WCP52/gpha/README.md

This repository contains the final product data for the WCP52 Gain/Phase
Analyzer.
