WCP52/gpha/PCB/README.rst

This is the final PCB for WCP52's gain/phase analyzer BSEE capstone project.
Layout is done in KiCad (latest testing revision) with libraries from
@cpavlina:

- https://github.com/cpavlina/kicad-schlib
- https://github.com/cpavlina/kicad-pcblib
