WCP52/gpha/PCB/RENDERS/3d-full.png

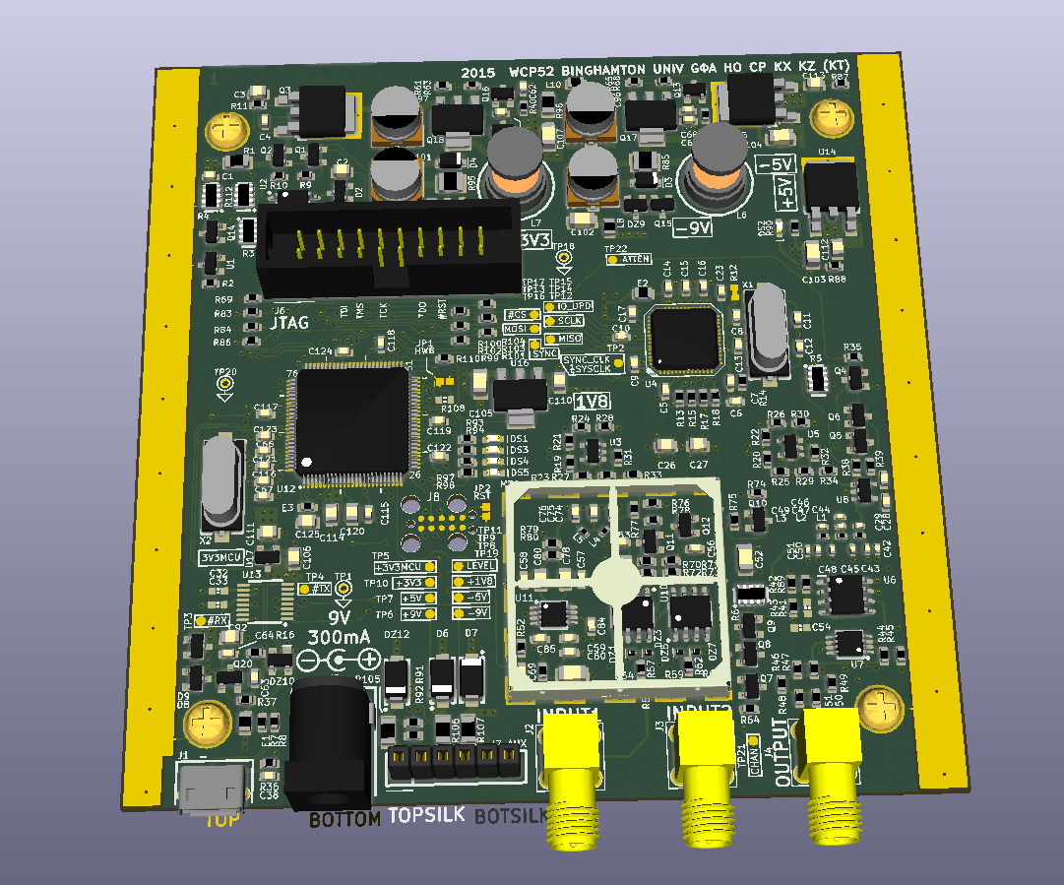
PCB/RENDERS/3d-full.png
