WCP52/gpha/PCB/RENDERS/schematic_small.png

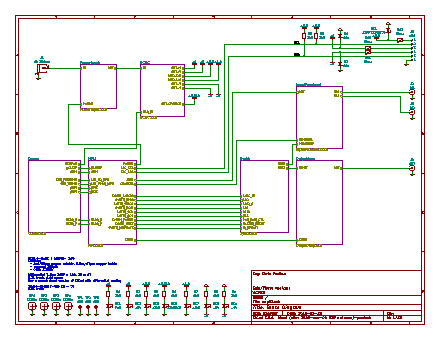
PCB/RENDERS/schematic_small.png
