WCP52/gpha/OwnersManual/autogen-bom.tex

\begin{longtable}{|l|l|l|l|l|}
\hline
\textbf{Reference} & \textbf{Manufacturer} & \textbf{Part Number} & \textbf{Line} & \textbf{Description} \\
\hline
\endhead
C1 &  &  & CAP MLCC 10n 50V 10\% \ensuremath{\geq}X5R [0603] &  \\
\hline
C2 &  &  & CAP MLCC 10n 50V 10\% \ensuremath{\geq}X5R [0603] &  \\
\hline
C3 &  &  & CAP MLCC 100n 16V 10\% \ensuremath{\geq}X7R [0603] &  \\
\hline
C4 &  &  & CAP MLCC 10n 50V 10\% \ensuremath{\geq}X5R [0603] &  \\
\hline
C5 &  &  & CAP MLCC 10\ensuremath{\mu} 10V 10\% \ensuremath{\geq}X5R [0805] &  \\
\hline
C8 &  &  & CAP MLCC 100n 16V 10\% \ensuremath{\geq}X7R [0603] &  \\
\hline
C9 &  &  & CAP MLCC 100n 16V 10\% \ensuremath{\geq}X7R [0603] &  \\
\hline
C10 &  &  & CAP MLCC 100n 16V 10\% \ensuremath{\geq}X7R [0603] &  \\
\hline
C11 &  &  & CAP MLCC 100n 16V 10\% \ensuremath{\geq}X7R [0603] &  \\
\hline
C12 &  &  & CAP MLCC 100n 16V 10\% \ensuremath{\geq}X7R [0603] &  \\
\hline
C13 &  &  & CAP MLCC 100n 16V 10\% \ensuremath{\geq}X7R [0603] &  \\
\hline
C14 &  &  & CAP MLCC 15p 50V 10\% C0G [0603] &  \\
\hline
C15 &  &  & CAP MLCC 15p 50V 10\% C0G [0603] &  \\
\hline
C16 &  &  & CAP MLCC 100n 16V 10\% \ensuremath{\geq}X7R [0603] &  \\
\hline
C17 &  &  & CAP MLCC 100n 16V 10\% \ensuremath{\geq}X7R [0603] &  \\
\hline
C18 &  &  & CAP MLCC 100n 16V 10\% \ensuremath{\geq}X7R [0603] &  \\
\hline
C19 &  &  & CAP MLCC 100n 16V 10\% \ensuremath{\geq}X7R [0603] &  \\
\hline
C20 &  &  & CAP MLCC 100n 16V 10\% \ensuremath{\geq}X7R [0603] &  \\
\hline
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
\hline
R98 &  &  & RES SMD 3R3 10\% [0603] &  \\
\hline
R99 &  &  & RES SMD 3R3 10\% [0603] &  \\
\hline
R102 &  &  & RES SMD 3k3 5\% [0603] &  \\
\hline
R103 &  &  & RES SMD 3k3 5\% [0603] &  \\
\hline
R104 &  &  & RES SMD 3k3 5\% [0603] &  \\
\hline
R105 &  &  & RES SMD 3k3 5\% [0603] &  \\
\hline
R106 &  &  & RES SMD 1k 5\% [0603] &  \\
\hline
R107 &  &  & RES SMD 1k 5\% [0603] &  \\
\hline
R108 &  &  & RES SMD 1k 5\% [0603] &  \\
\hline
R109 &  &  & RES SMD 1k 5\% [0603] &  \\
\hline
R110 &  &  & RES SMD 200 1\% [0603] &  \\
\hline
R111 &  &  & RES SMD 3k3 5\% [0603] &  \\
\hline
R112 &  &  & RES SMD 200 1\% [0603] &  \\
\hline
R113 &  &  & RES SMD 200 1\% [0603] &  \\
\hline
R114 &  &  & RES SMD 200 1\% [0603] &  \\
\hline
R115 &  &  & RES SMD 200 1\% [0603] &  \\
\hline
R116 &  &  & RES SMD 200 1\% [0603] &  \\
\hline
R117 &  &  & RES SMD 360 1\% [0603] &  \\
\hline
U2 &  &  & IC TI LMH6714MF &  \\
\hline
U3 &  &  & IC ADI AD9958BCPZ &  \\
\hline
U4 &  &  & IC TI LMH6714MF &  \\
\hline
U5 &  &  & IC ADI AD8000YRDZ &  \\
\hline
U6 &  &  & IC TI THS3001IDGN &  \\
\hline
U7 &  &  & IC MACOM MAADSS0008 &  \\
\hline
U8 &  &  & IC MACOM MASWSS0162 &  \\
\hline
U9 &  &  & IC MACOM MASWSS0162 &  \\
\hline
U10 &  &  & IC ADI AD8310ARMZ &  \\
\hline
U11 &  &  & IC TI TL431AIDBZ &  \\
\hline
U12 &  &  & IC GENERIC LM393M &  \\
\hline
U13 &  &  & IC ST L78M05CDT &  \\
\hline
U14 &  &  & IC ONSEMI MC79M05CDTG &  \\
\hline
U15 &  &  & IC DIODES AZ1117CH-1.8TRG1 &  \\
\hline
U16 &  &  & IC MICROCHIP MCP1700T-3302E/TT &  \\
\hline
U18 &  &  & IC ATMEL ATSAM4S4CA-AU &  \\
\hline
X1 & TXC & 9C-25.000MEEJ-T & DIST DIGIKEY 887-1283-1-ND & CRYSTAL 25MHz 18pF 10PPM \\
\hline
X2 & Abracon & ABLS-12.000MHZ-B4-T & DIST DIGIKEY 535-10218-1-ND & CRYSTAL 12MHz 18pF \\
\hline
\end{longtable}
