WCP52/gpha/PCB/RENDERS/schematic.pdf

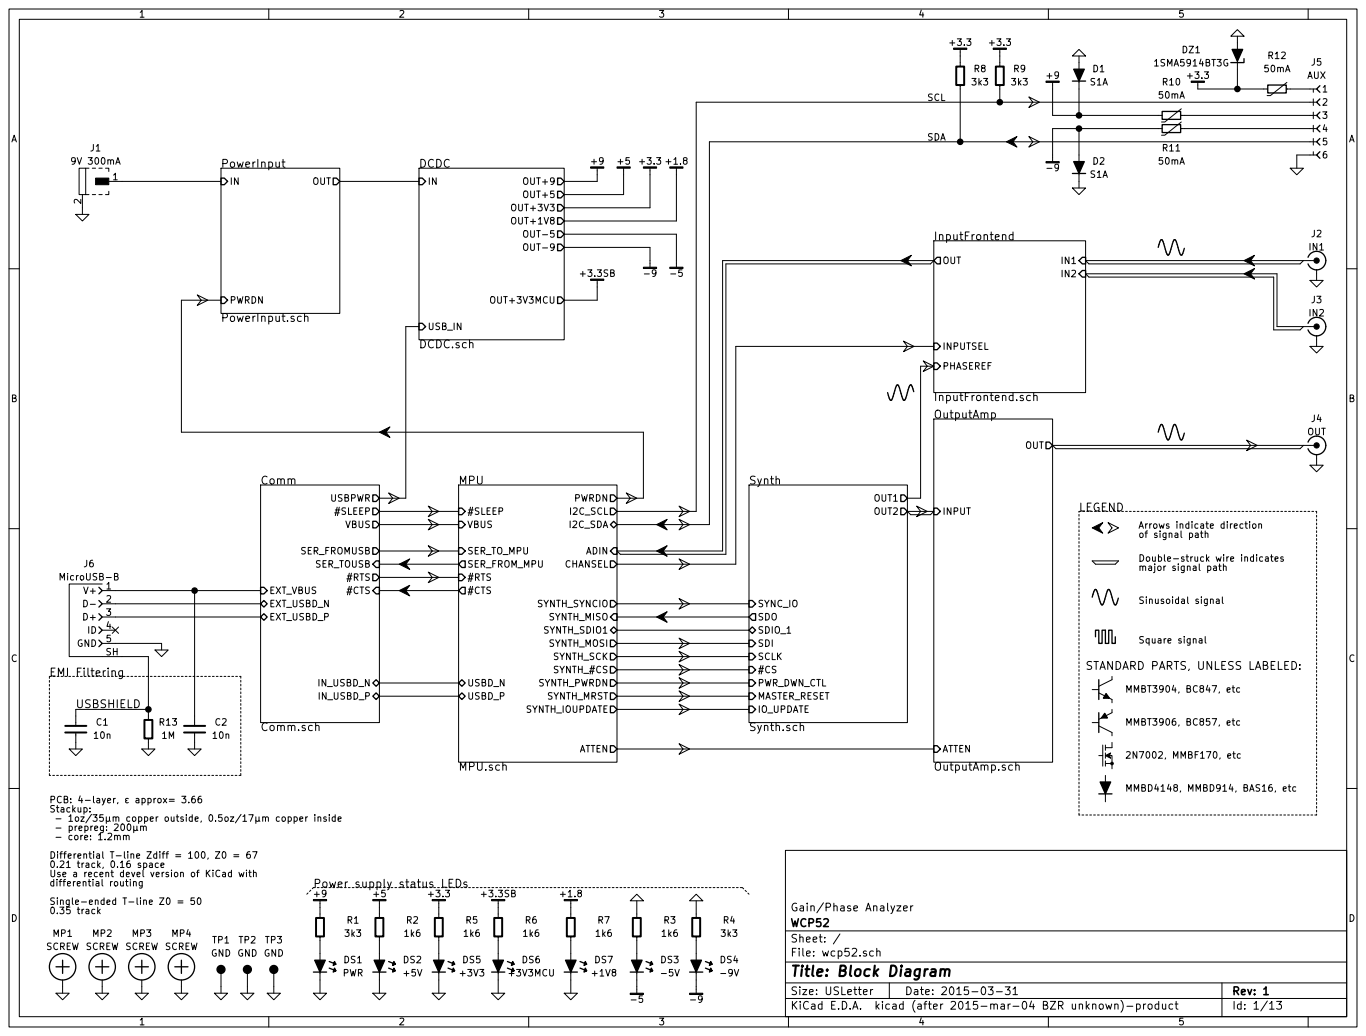
[picture p10: page 1]

Arrows indicate direction
of signal path Double-struck wire indicates major signal path

STANDARD PARTS, UNLESS LABELED: MMBT3904, BC847, etc MMBT3906, BC857, etc MMBD4148, MMBD914, BAS16, etc 2N7002, MMBF170, etc Power supply status LEDs
IN_USBD_N
IN_USBD_P

PCB: 4-layer, approx= 3.66
Stackup:
- 1oz/35µm copper outside, 0.5oz/17µm copper inside
- prepreg: 200µm
- core: 1.2mm
Differential T-line Zdiff = 100, Z0 = 67
0.21 track, 0.16 space Use a recent devel version of KiCad with
differential routing
Single-ended T-line Z0 = 50

File: wcp52.sch Sheet: / WCP52 Gain/Phase Analyzer

Id: 1/13 Title: Block Diagram

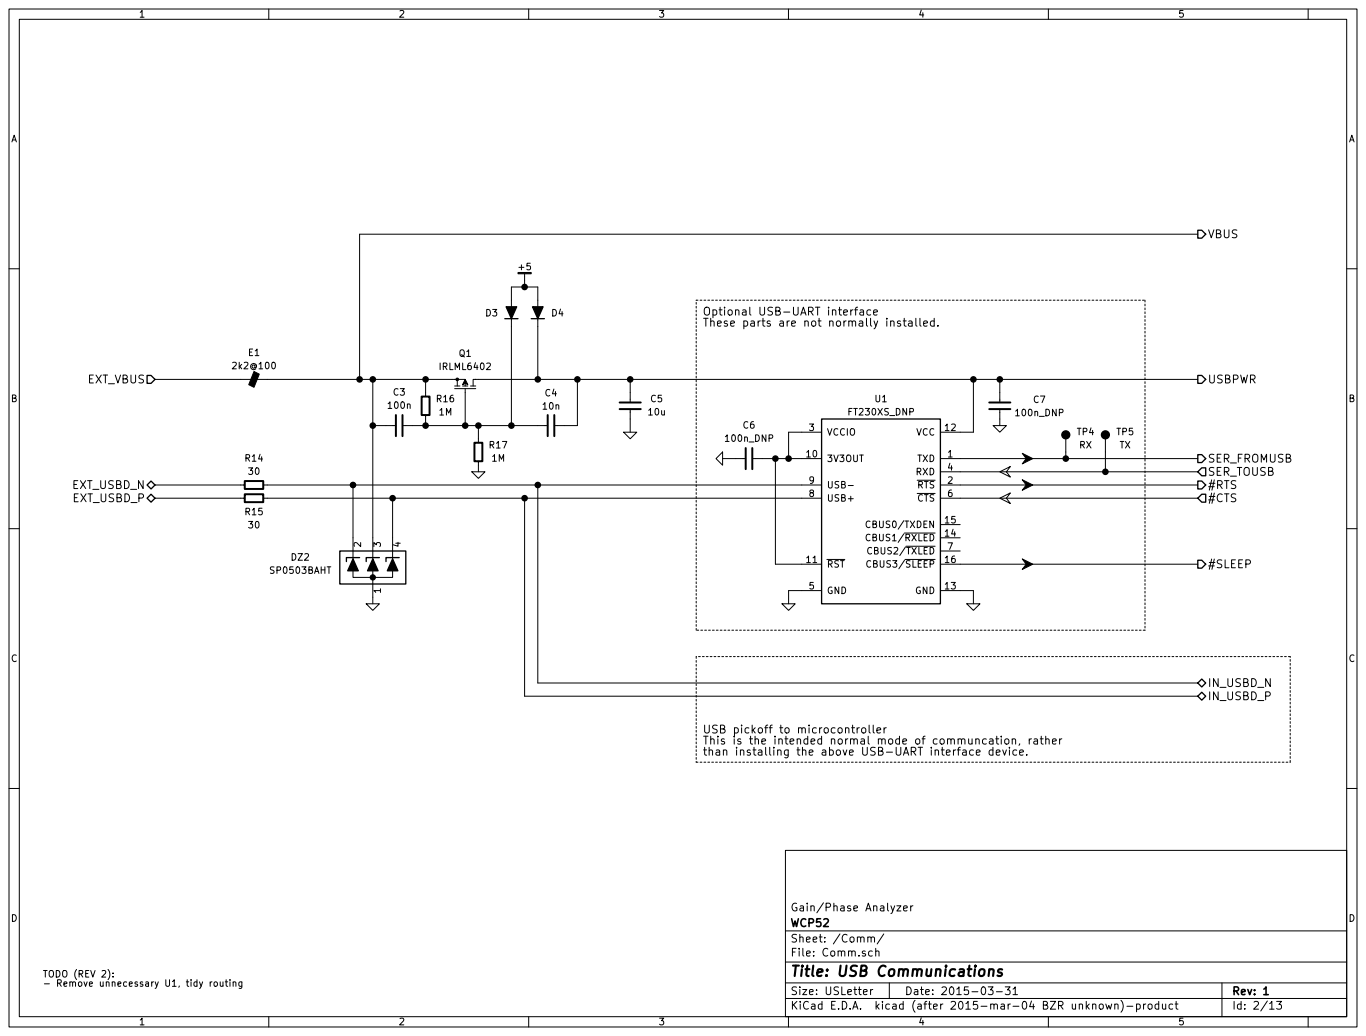
[picture p11: page 2]

Optional USB-UART interface
These parts are not normally installed.

USB pickoff to microcontroller
This is the intended normal mode of communcation, rather
than installing the above USB-UART interface device.

File: Comm.sch Sheet: /Comm/ WCP52 Gain/Phase Analyzer

TODO (REV 2):
- Remove unnecessary U1, tidy routing

Id: 2/13 Title: USB Communications

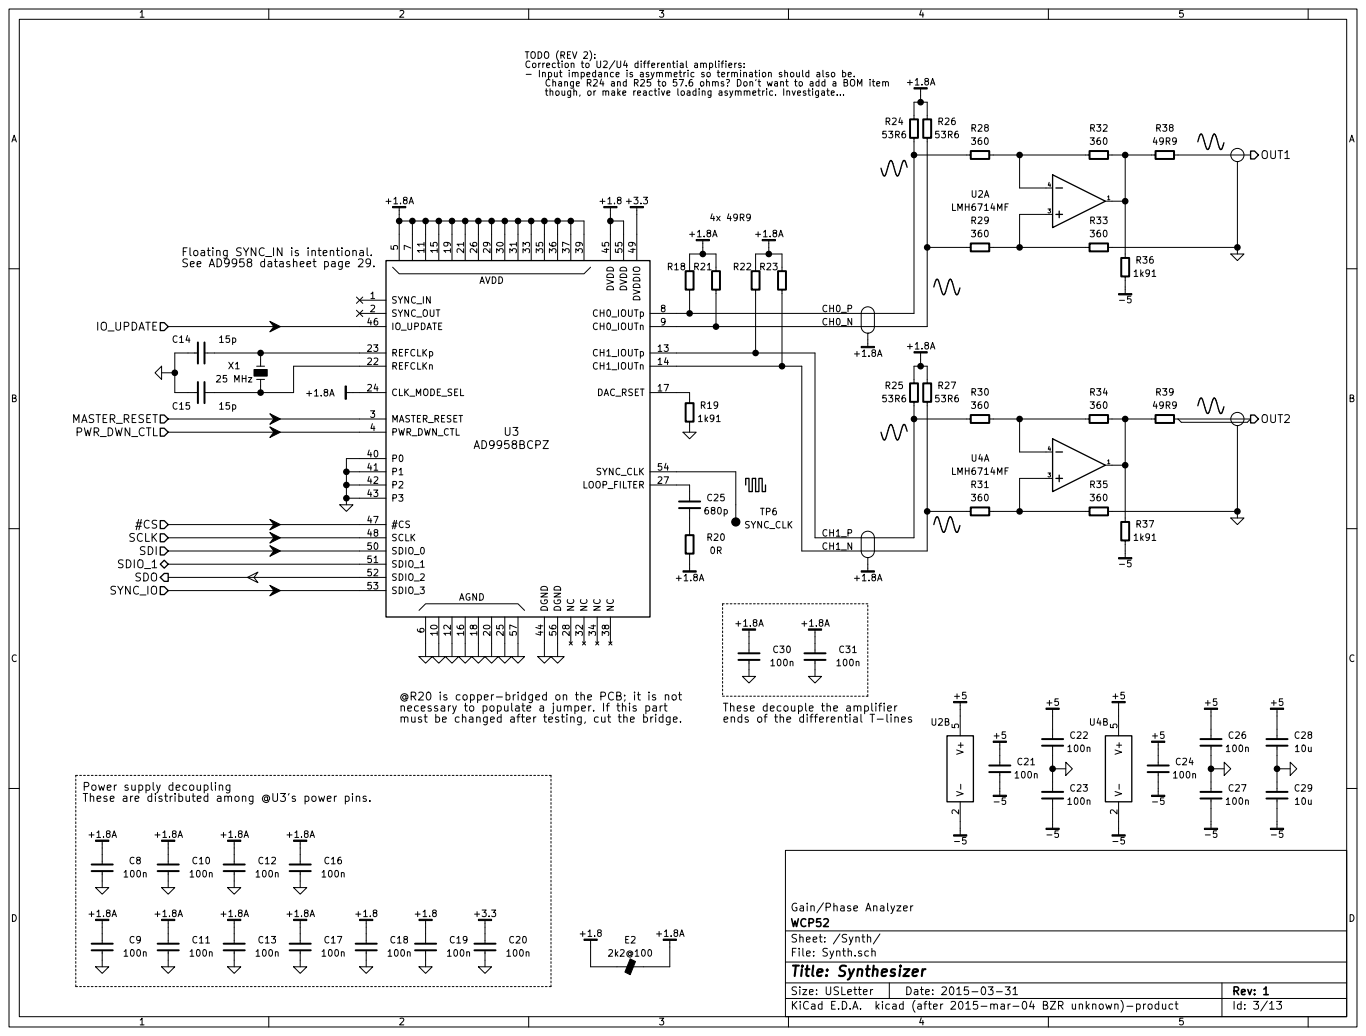
[picture p12: page 3]

TODO (REV 2):
Correction to U2/U4 differential amplifiers:
- Input impedance is asymmetric so termination should also be.
Change R24 and R25 to 57.6 ohms? Don't want to add a BOM item
though, or make reactive loading asymmetric. Investigate...

7 CH0_IOUTp 8 CH0_IOUTn 9 1020 30 P0 40 SDIO_0 50 112131 P1 41 SDIO_1 51 12 REFCLKn 22 NC 32 P2 42 SDIO_2 52 CH1_IOUTp 13 REFCLKp 23 33 P3 43 SDIO_3 53 CH1_IOUTn 14 CLK_MODE_SEL 24 NC 34 DGND 44 SYNC_CLK 54 15 25 35 DVDD 45 DVDD 55 16 2636

0R @R20 is copper-bridged on the PCB; it is not

Sheet: /Synth/ WCP52 Gain/Phase Analyzer AGND

must be changed after testing, cut the bridge. C8

necessary to populate a jumper. If this part

These are distributed among @U3's power pins.

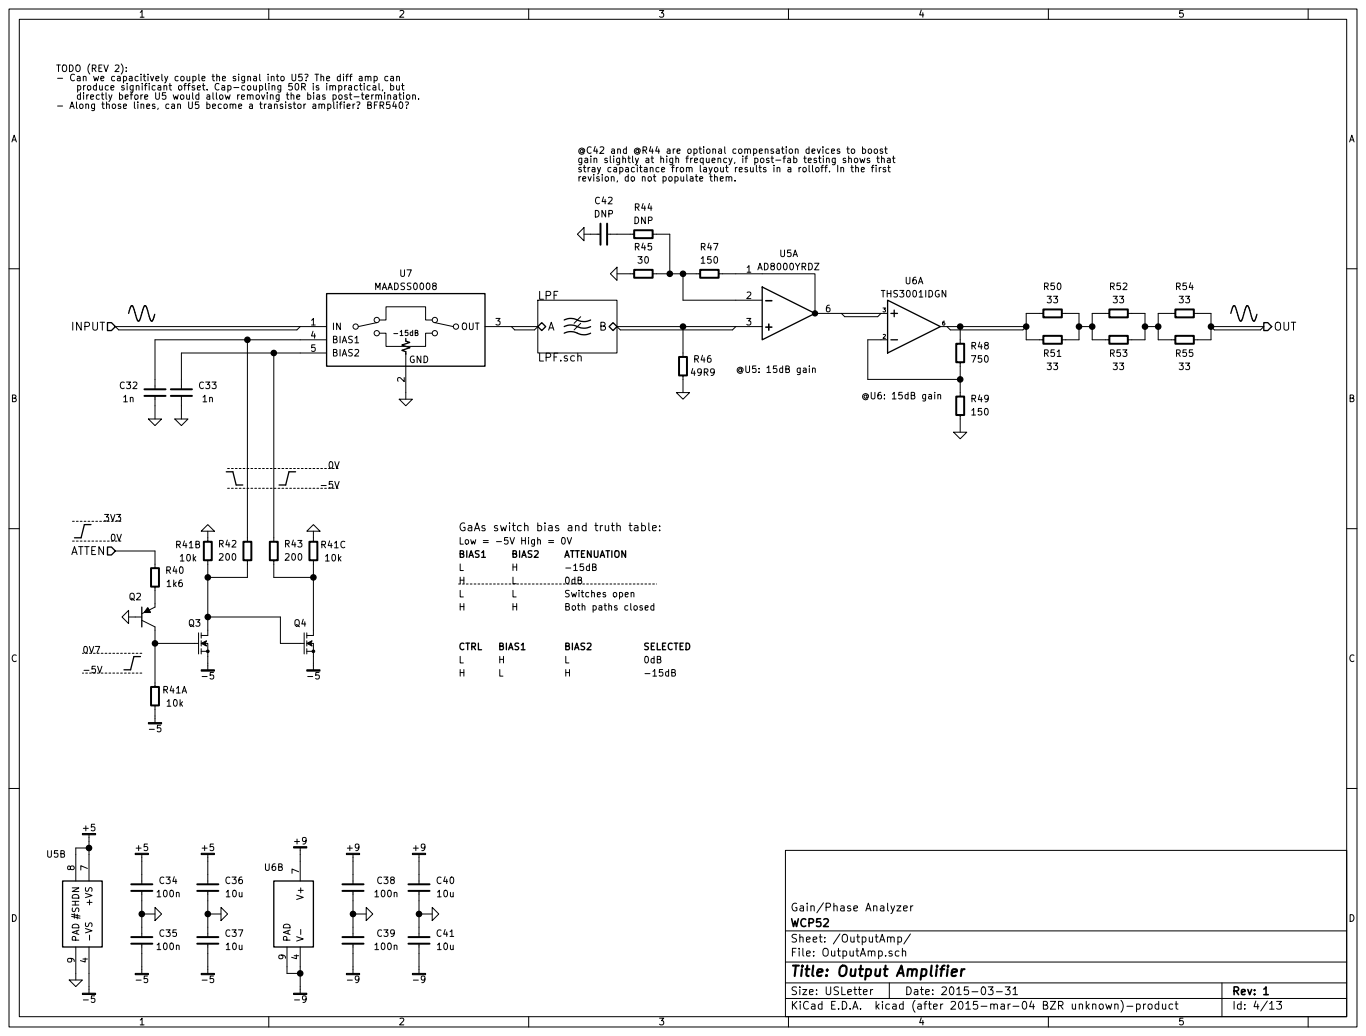
[picture p13: page 4]

TODO (REV 2):
- Can we capacitively couple the signal into U5? The diff amp can
produce significant offset. Cap-coupling 50R is impractical, but
directly before U5 would allow removing the bias post-termination.
- Along those lines, can U5 become a transistor amplifier? BFR540?

@C42 and @R44 are optional compensation devices to boost
gain slightly at high frequency, if post-fab testing shows that
stray capacitance from layout results in a rolloff. In the first
revision, do not populate them.

GaAs switch bias and truth table:

Sheet: /OutputAmp/ WCP52 Gain/Phase Analyzer

File: OutputAmp.sch
Id: 4/13 Title: Output Amplifier

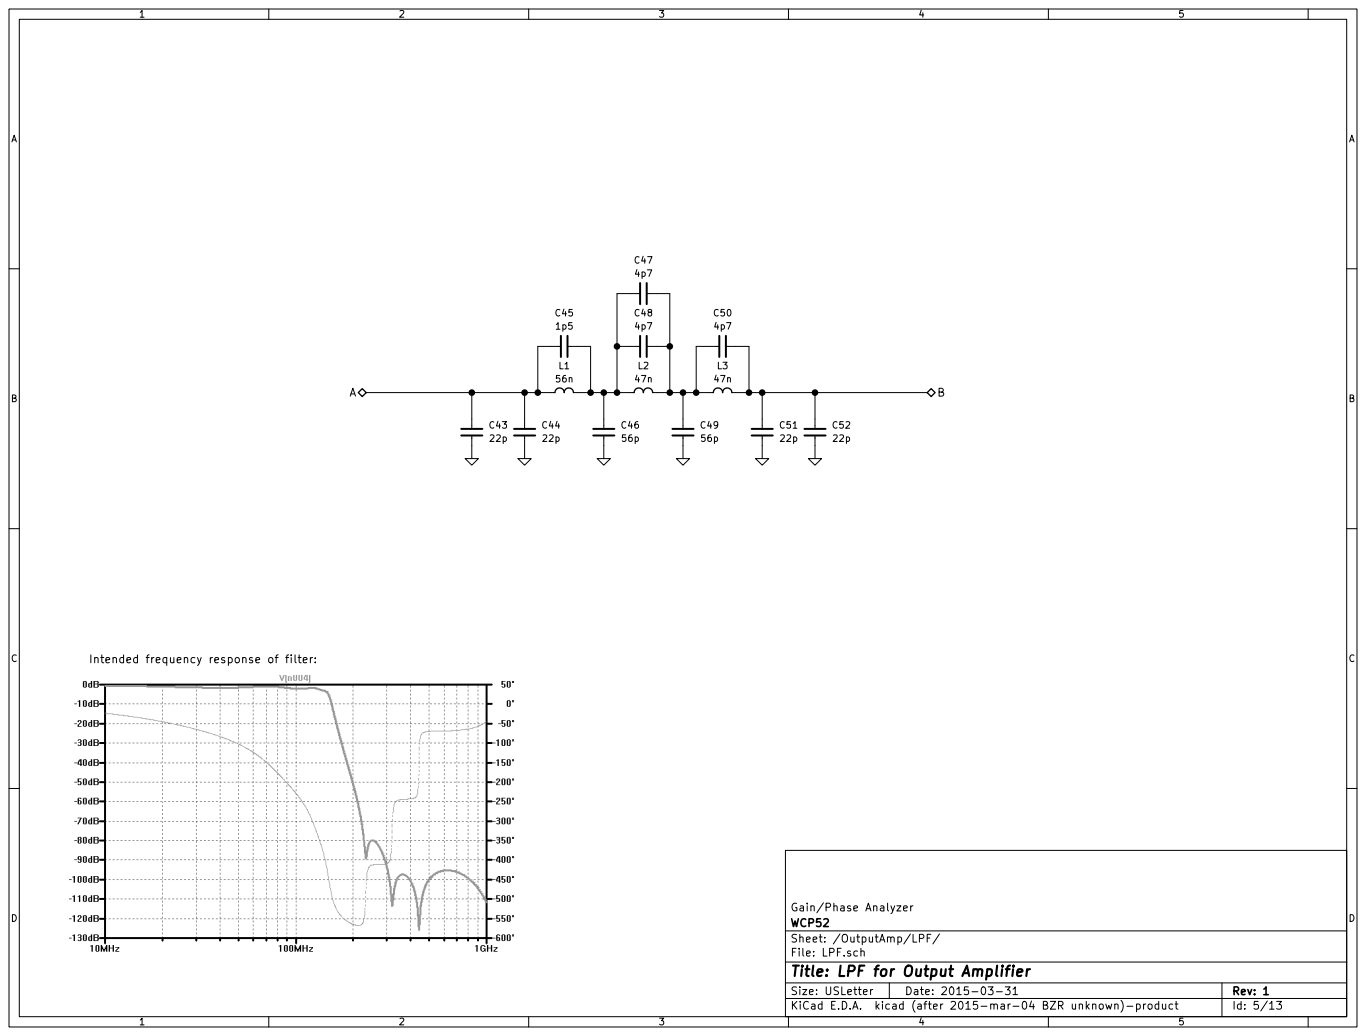
[picture p14: page 5]

Intended frequency response of filter:

Id: 5/13 Title: LPF for Output Amplifier File: LPF.sch Sheet: /OutputAmp/LPF/ WCP52 Gain/Phase Analyzer

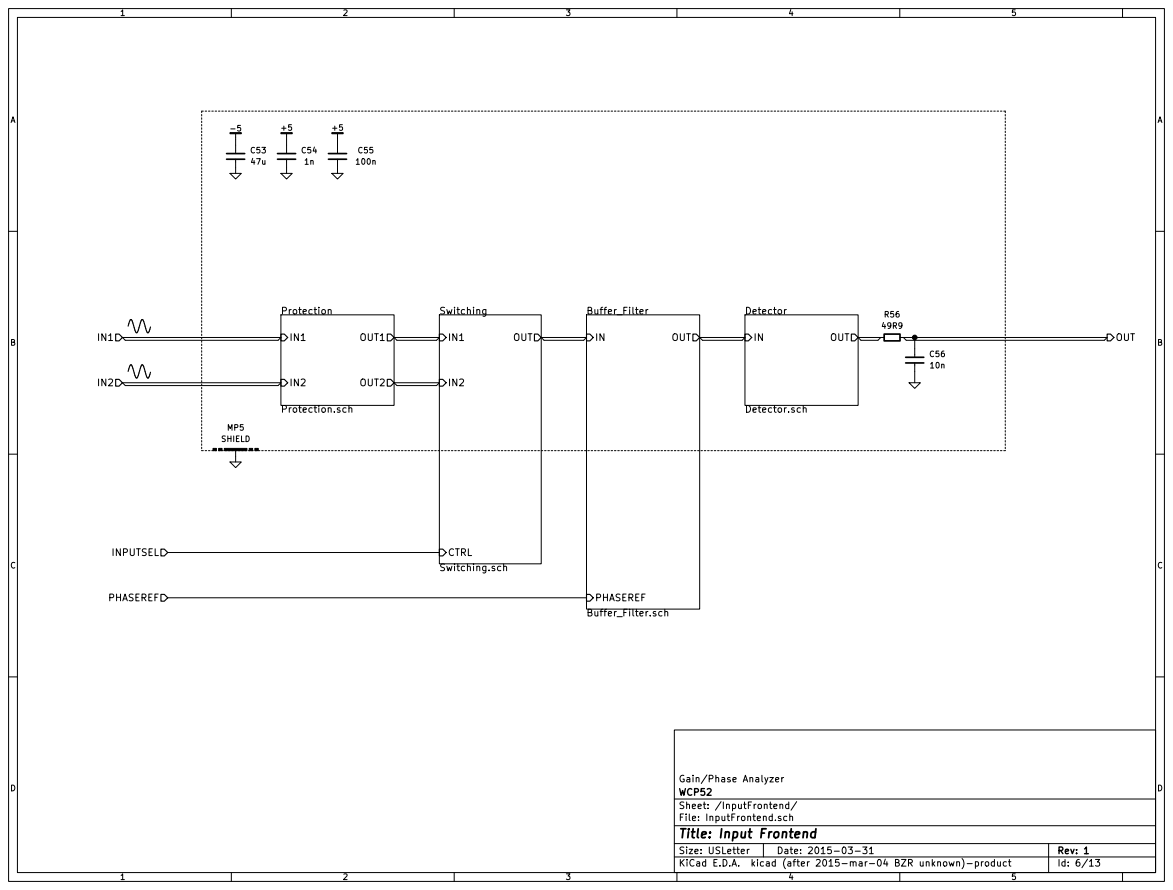
[picture p15: page 6]

File: InputFrontend.sch
Id: 6/13 Title: Input Frontend

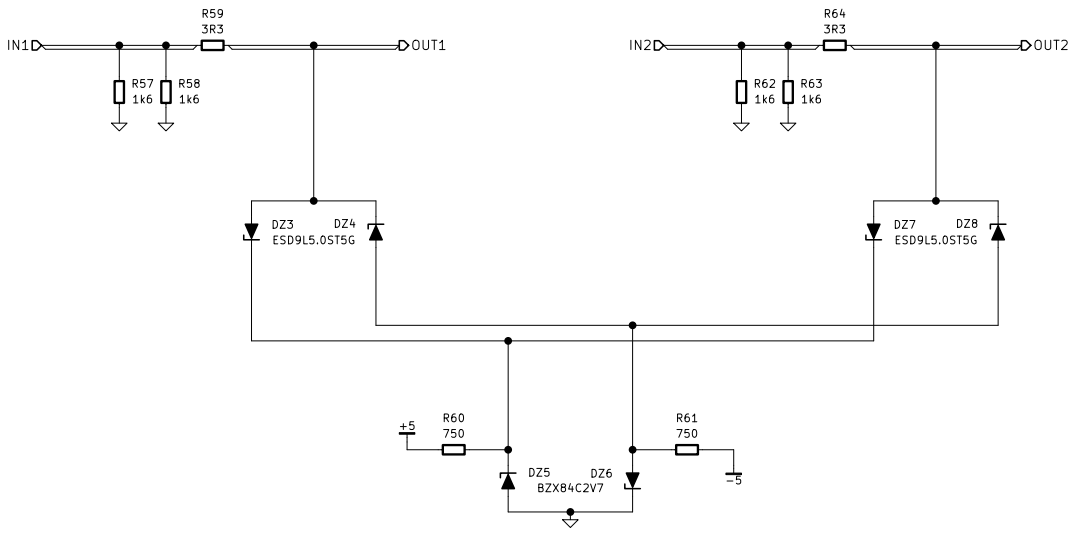
[picture p16: page 7]

File: Protection.sch Sheet: /InputFrontend/Protection/ WCP52 Gain/Phase Analyzer

Id: 7/13 Title: Input Protection

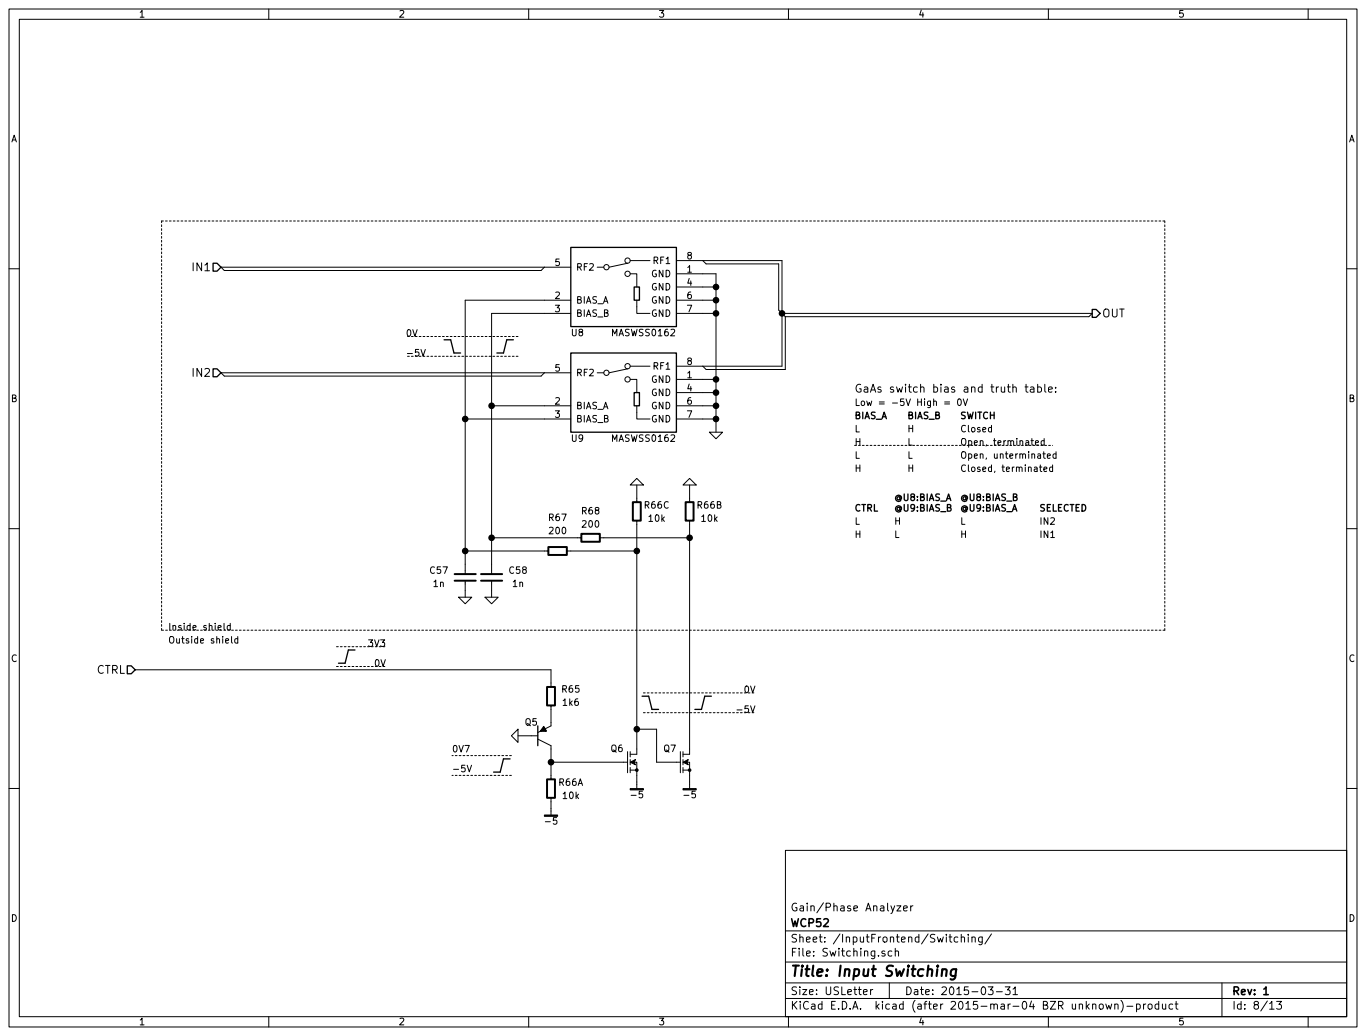
[picture p17: page 8]

Sheet: /InputFrontend/Switching/ WCP52 Gain/Phase Analyzer

File: Switching.sch
Id: 8/13 Title: Input Switching

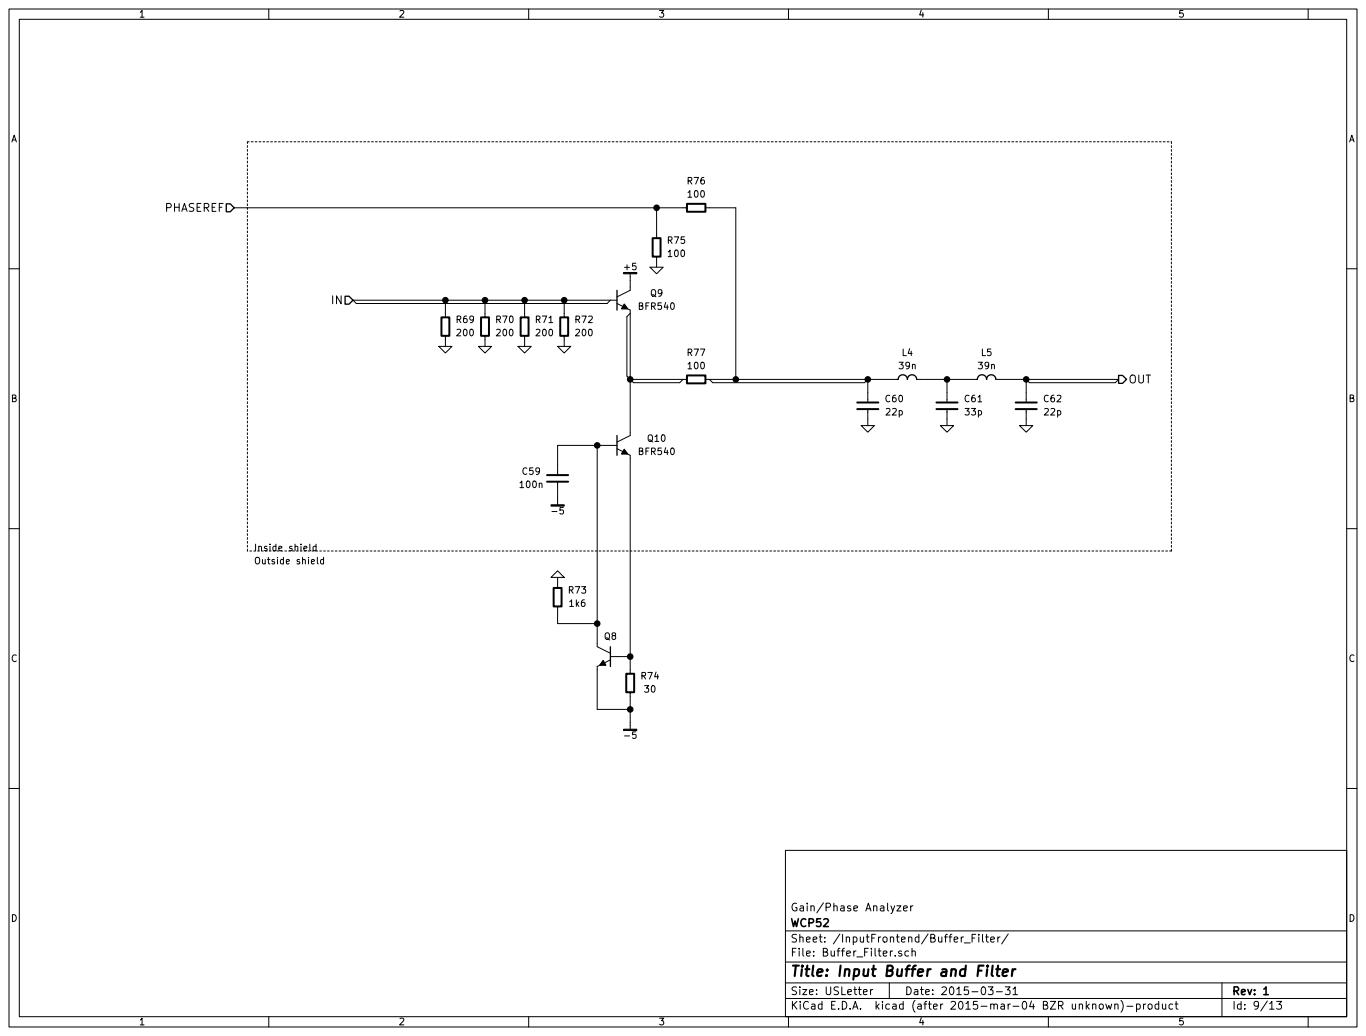
[picture p18: page 9]

Inside shield Outside shield

Sheet: /InputFrontend/Buffer_Filter/ WCP52 Gain/Phase Analyzer

File: Buffer_Filter.sch
Id: 9/13 Title: Input Buffer and Filter

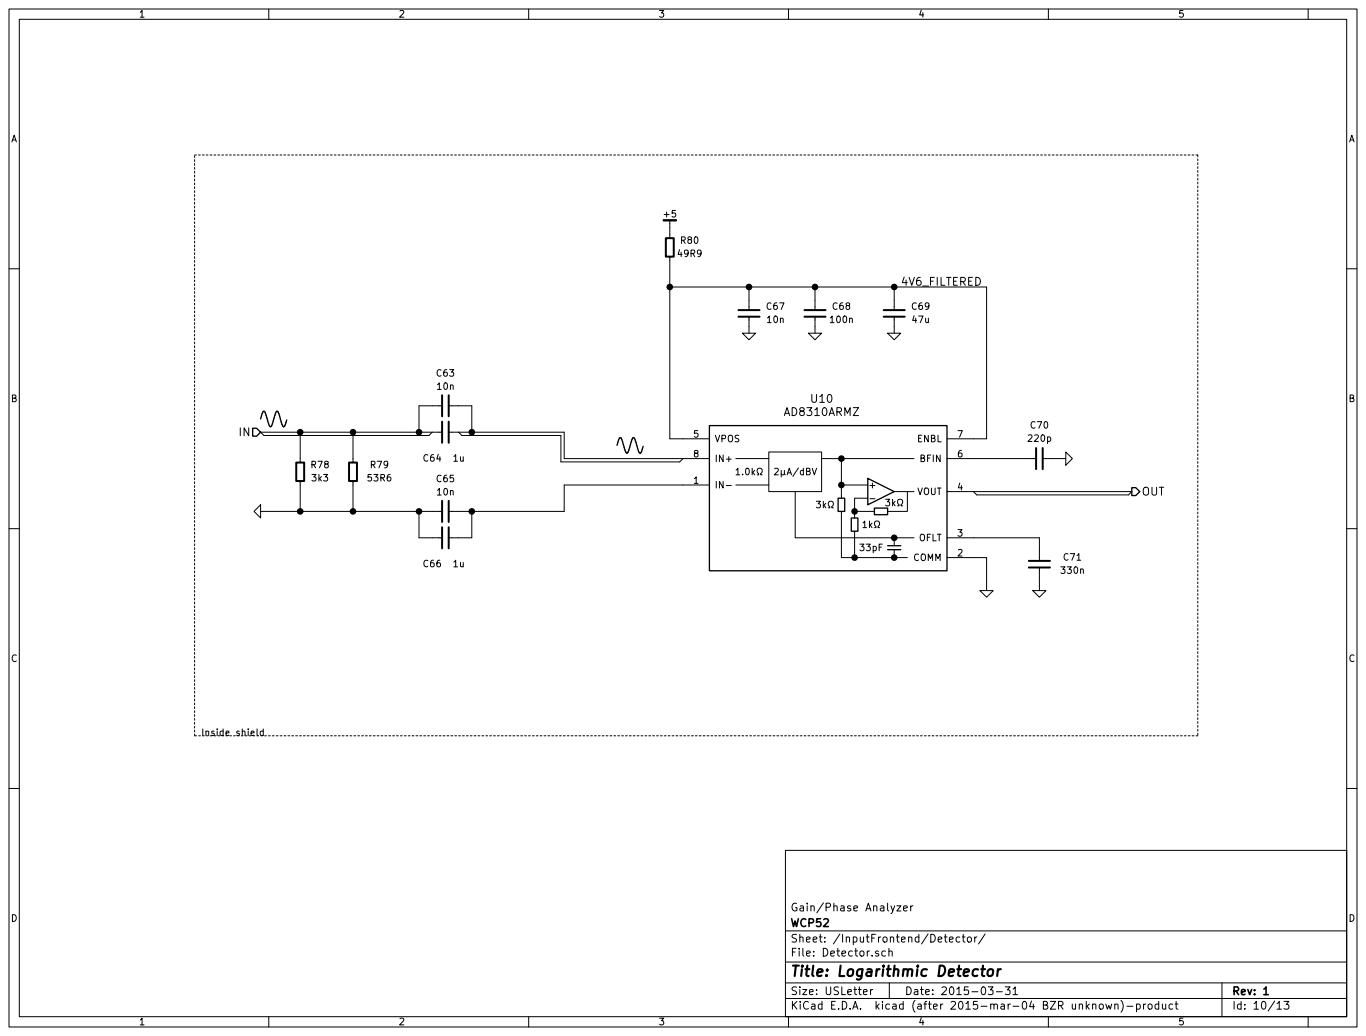
[picture p19: page 10]

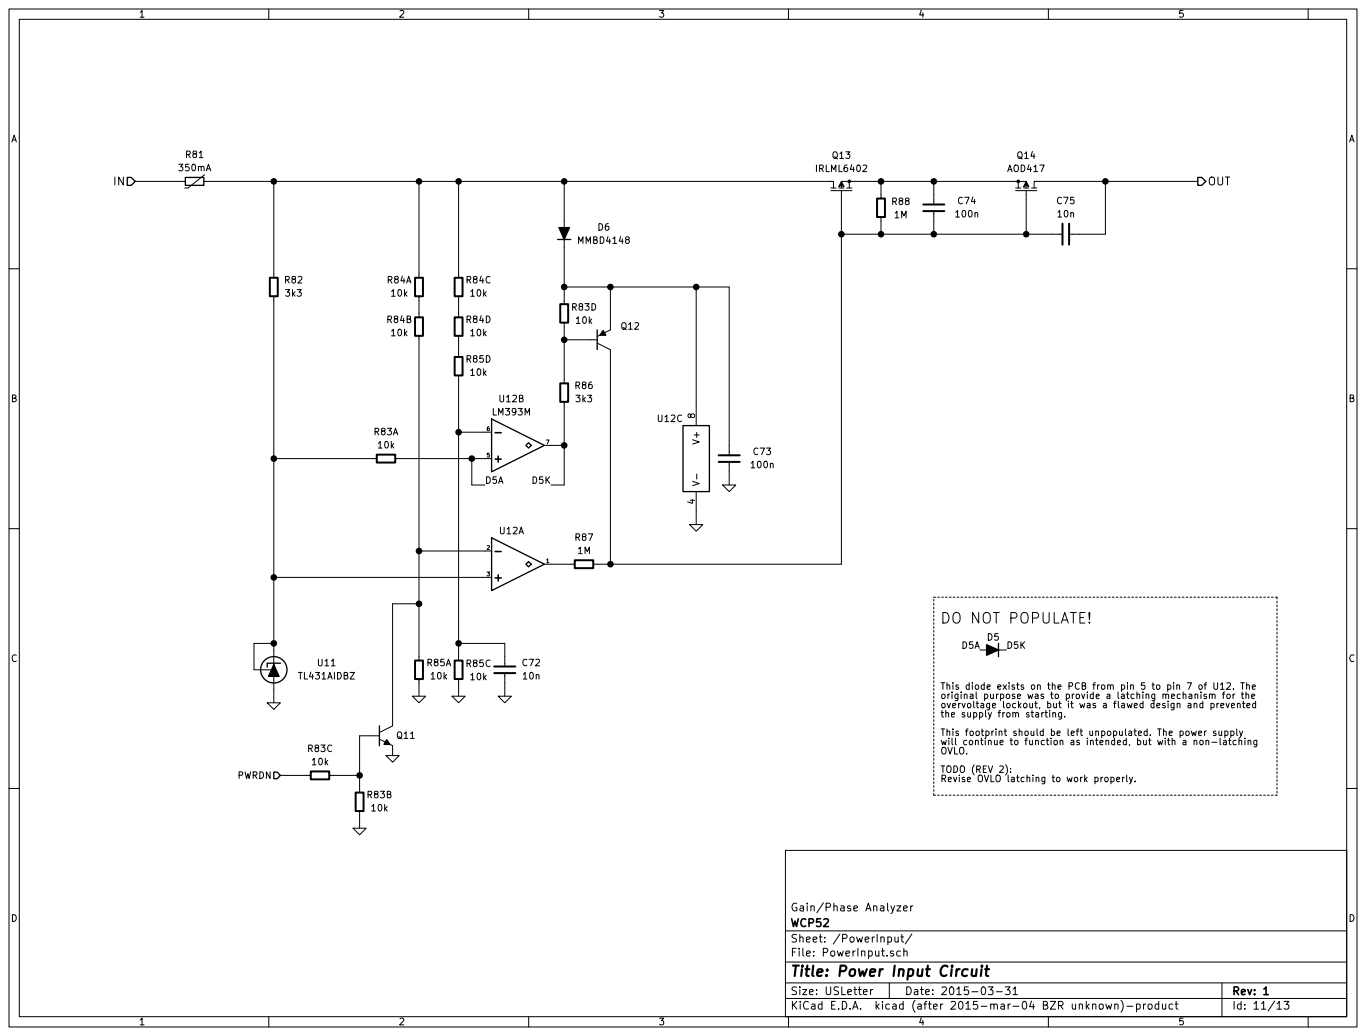
[picture p20: page 11]

This diode exists on the PCB from pin 5 to pin 7 of U12. The
original purpose was to provide a latching mechanism for the
overvoltage lockout, but it was a flawed design and prevented
the supply from starting.
This footprint should be left unpopulated. The power supply
will continue to function as intended, but with a non-latching OVLO. TODO (REV 2):

Sheet: /PowerInput/ WCP52 Gain/Phase Analyzer

File: PowerInput.sch
Id: 11/13 Title: Power Input Circuit

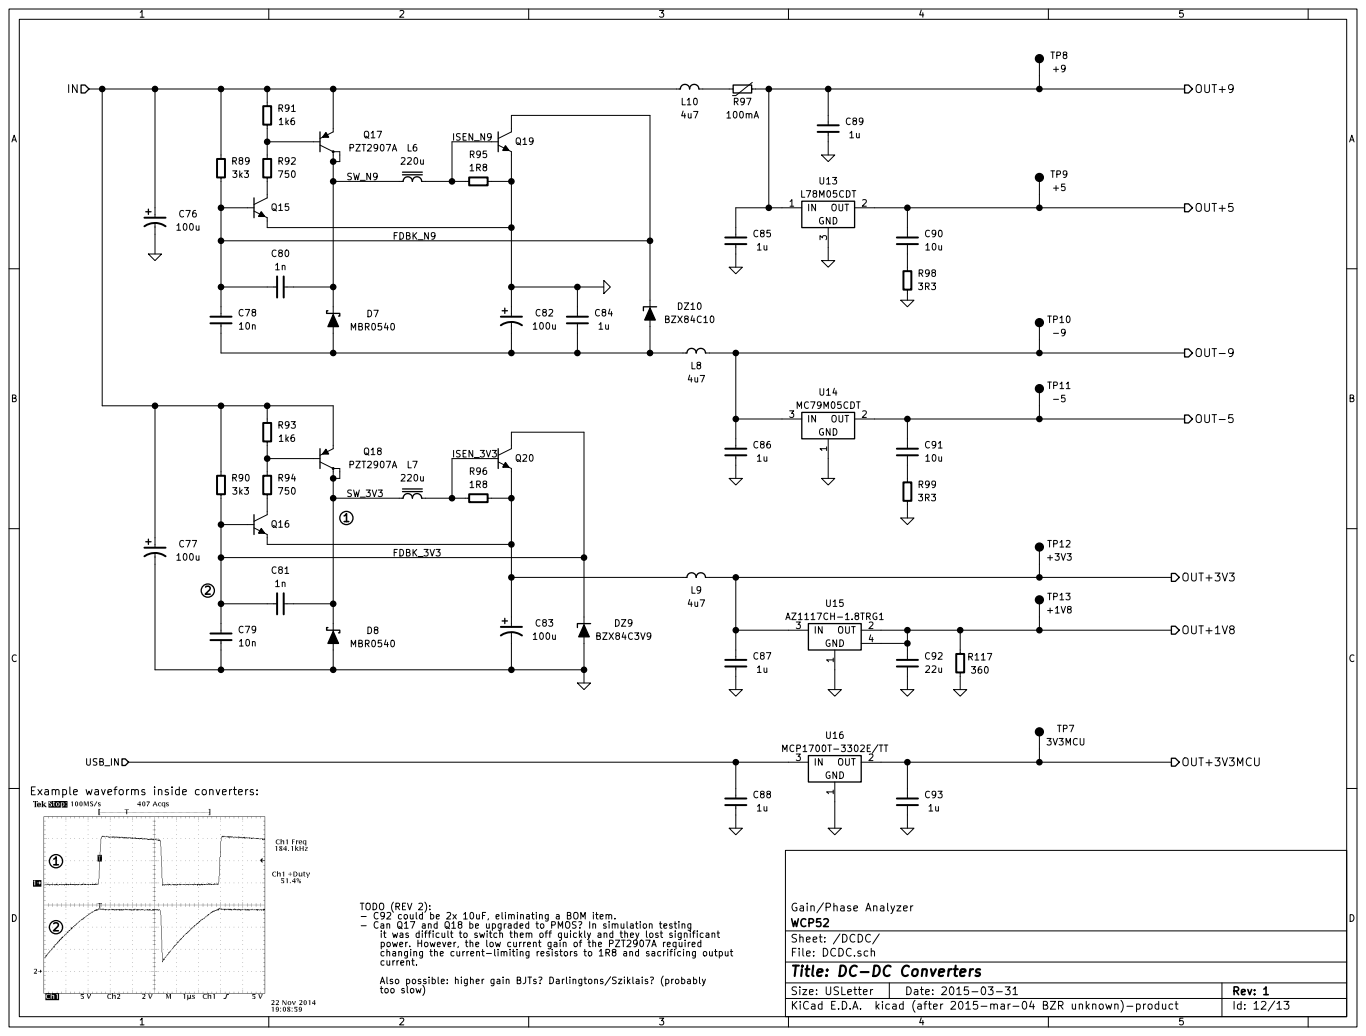
[picture p21: page 12]

TODO (REV 2):
- C92 could be 2x 10uF, eliminating a BOM item.
- Can Q17 and Q18 be upgraded to PMOS? In simulation testing
it was difficult to switch them off quickly and they lost significant
power. However, the low current gain of the PZT2907A required
changing the current-limiting resistors to 1R8 and sacrificing output
current.
Also possible: higher gain BJTs? Darlingtons/Sziklais? (probably
too slow)

File: DCDC.sch Sheet: /DCDC/ WCP52 Gain/Phase Analyzer

Id: 12/13 Title: DC-DC Converters

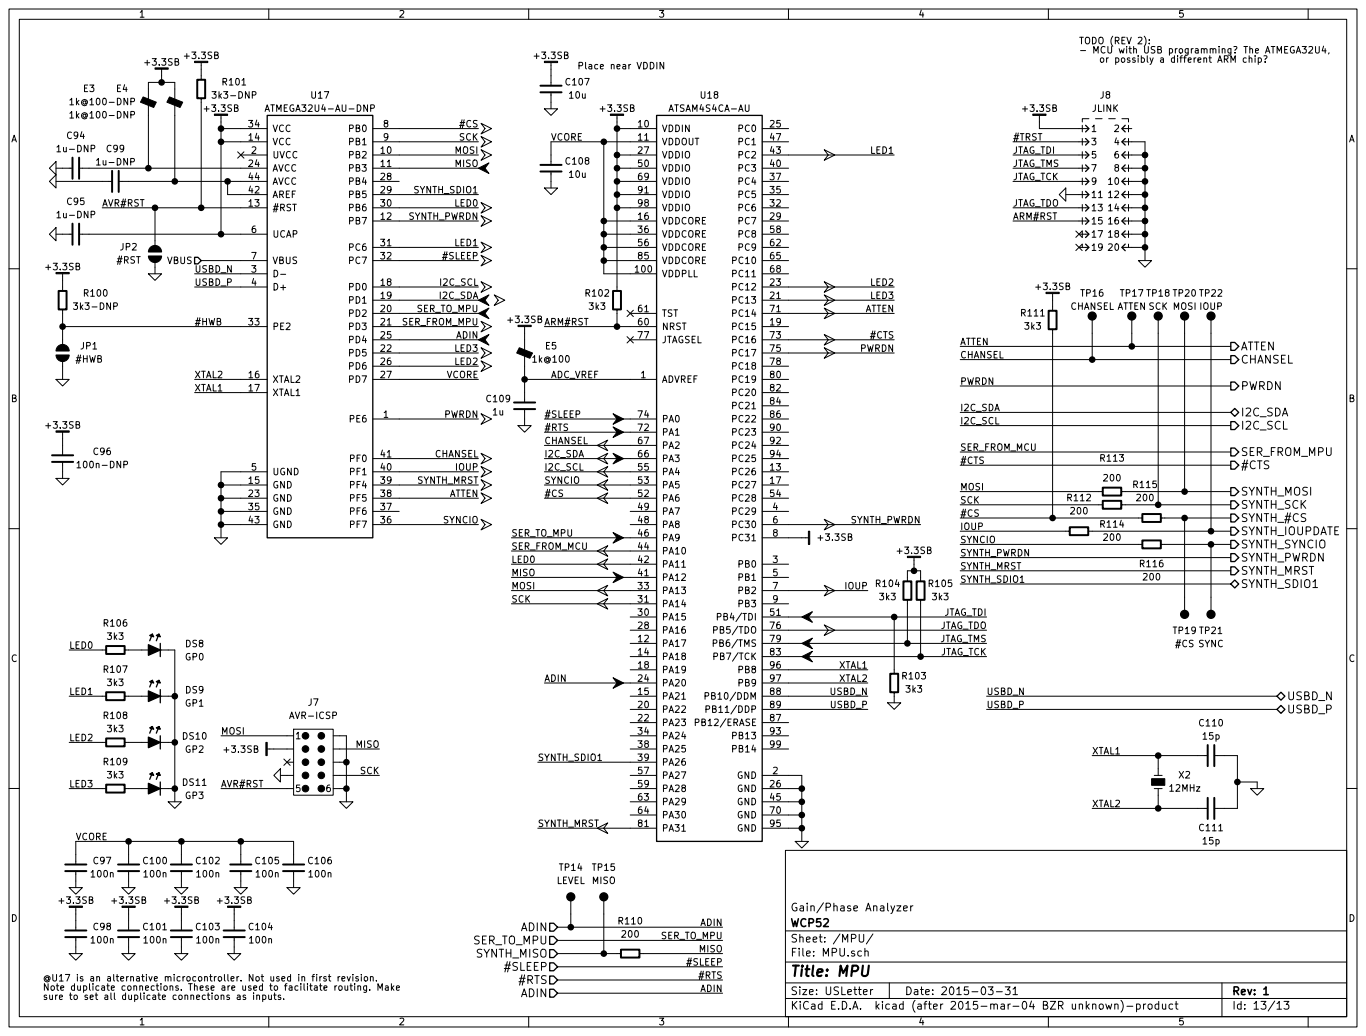
[picture p22: page 13]

TODO (REV 2):
- MCU with USB programming? The ATMEGA32U4,
or possibly a different ARM chip?

LED2 @U17 is an alternative microcontroller. Not used in first revision. Note duplicate connections. These are used to facilitate routing. Make

File: MPU.sch Sheet: /MPU/ WCP52 Gain/Phase Analyzer

sure to set all duplicate connections as inputs.
