WCP52/gpha/PCB/wcp52/wcp52.kicad_pcb

## KiCad design PCB/wcp52/wcp52.kicad_pcb (2015-04-11)

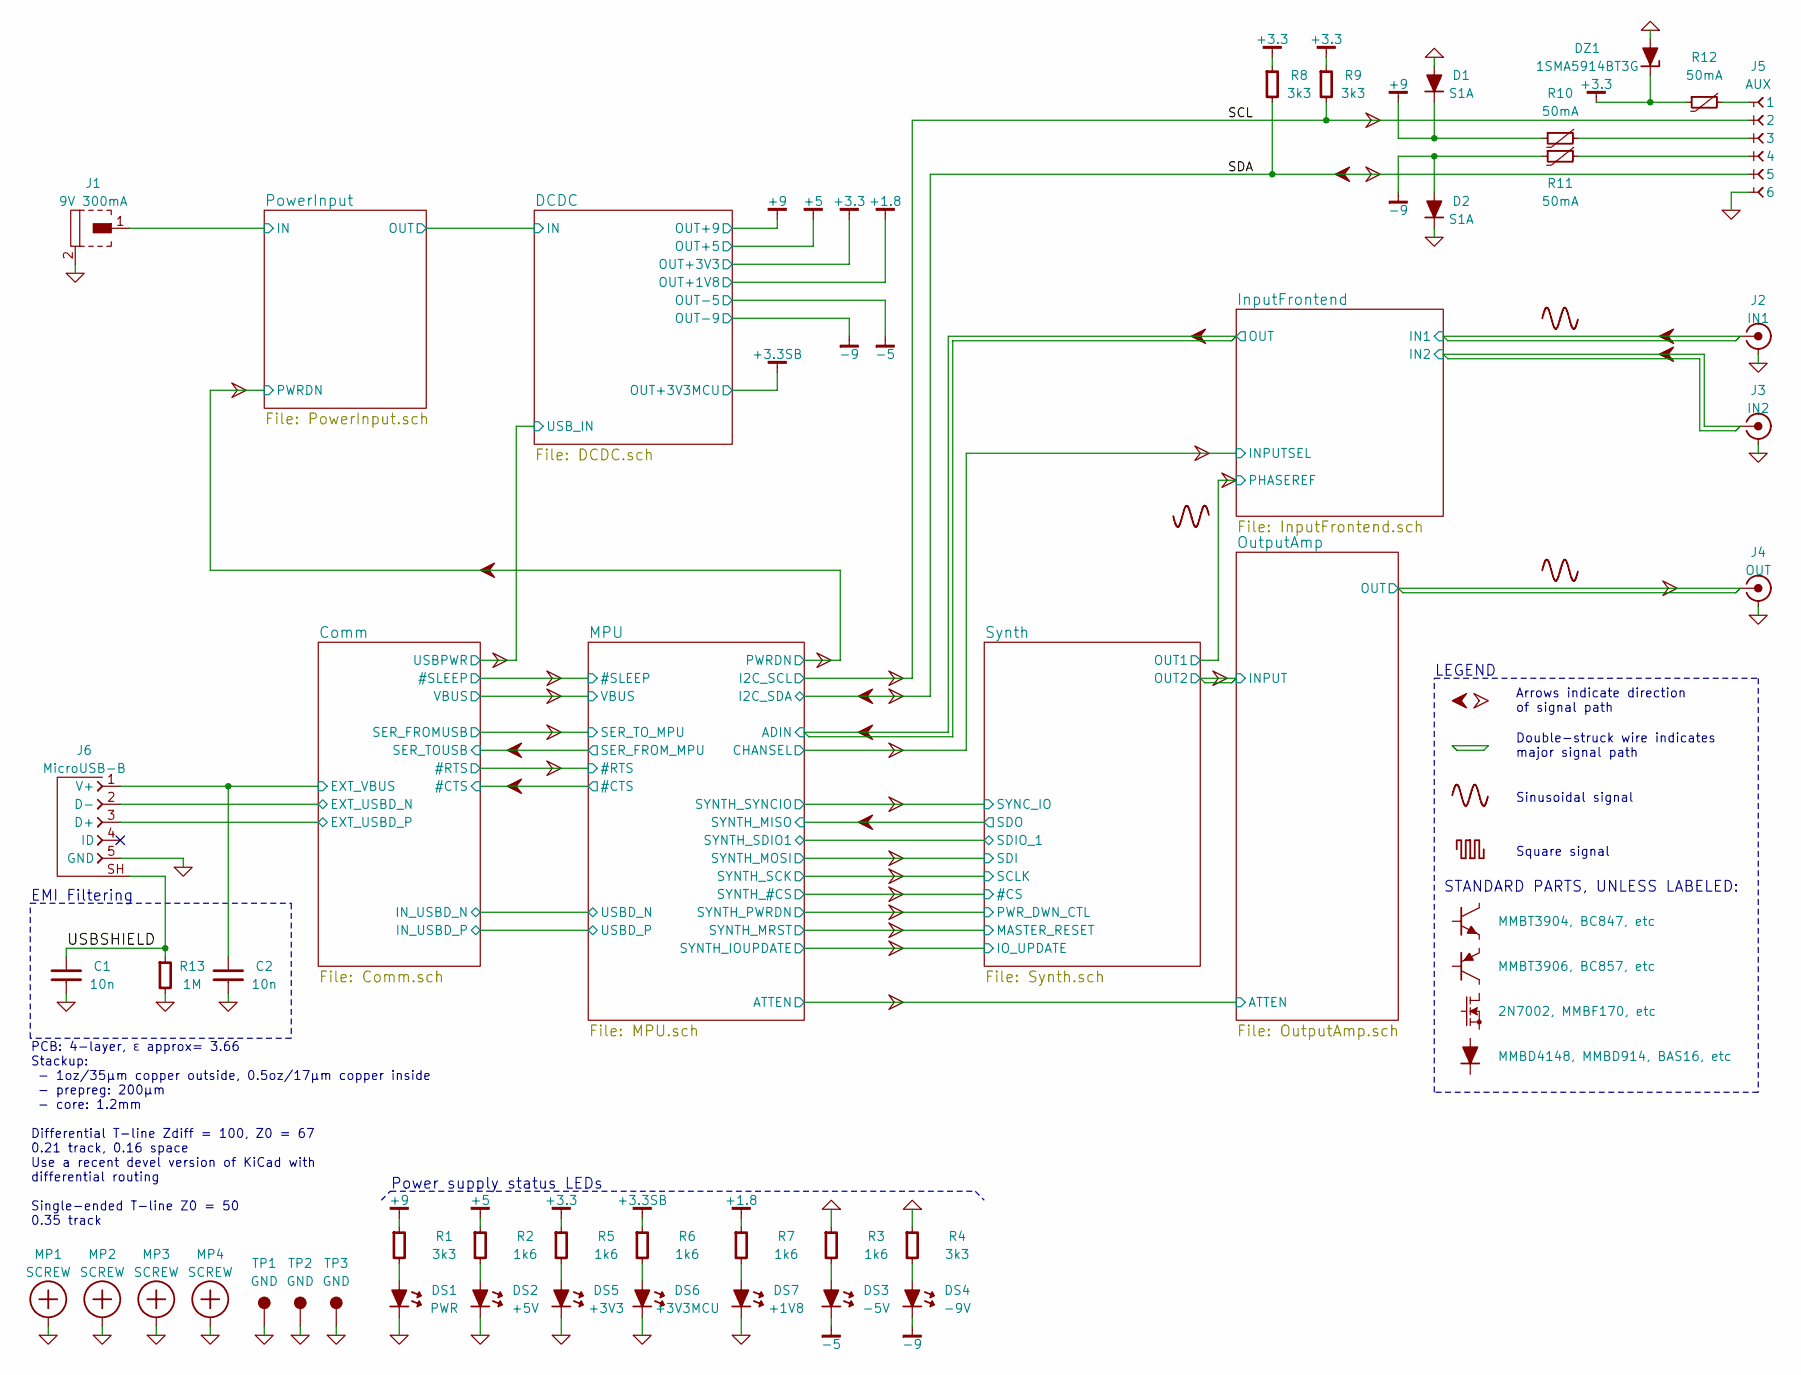
[picture p23: schematic wcp52.sch, Block Diagram]

Parts:
C1, C2: 10n; CAPC1608X55
D1, D2: S1A; DIOM5326X292
DS1: PWR; LED-3mm
DS2: +5V; LED-0603
DS3: -5V; LED-0603
DS4: -9V; LED-0603
DS5: +3V3; LED-0603
DS6: +3V3MCU; LED-0603
DS7: +1V8; LED-0603
DZ1: 1SMA5914BT3G; DIOM5226X203
J1: 9V 300mA; CONN-PJ-037A
J2: IN1; CONN-TE-1814400
J3: IN2; CONN-TE-1814400
J4: OUT; CONN-TE-1814400
J5: AUX; CONN-100MIL-F-1x6
J6: MicroUSB-B; CONN-10118194-0001LF-FCI
MP1, MP2, MP3, MP4: SCREW; SCREW-3-SUPPORTED
R1, R4, R8, R9: 3k3; RESC1608X50
R2, R3, R5, R6, R7: 1k6; RESC1608X50
R10, R11, R12: 50mA; RESC3216X60
R13: 1M; RESC1608X50
TP1, TP2, TP3: GND; TEST-SMD-SMALL

Connections:
+1.8: R7.1; also elsewhere on the board
+3.3: DZ1.1, R5.1, R8.1, R9.1, R12.1; also elsewhere on the board
+3.3SB: R6.1; also elsewhere on the board
+5: R2.1; also elsewhere on the board
+9: D1.1, R1.1, R10.1; also elsewhere on the board
-5: DS3.1; also elsewhere on the board
-9: D2.2, DS4.1, R11.1; also elsewhere on the board
/Comm/EXT_USBD_N: J6.2 (D-); also elsewhere on the board
/Comm/EXT_USBD_P: J6.3 (D+); also elsewhere on the board
/Comm/EXT_VBUS: C2.1, J6.1 (V+); also elsewhere on the board
/InputFrontend/IN1: J2.1; also elsewhere on the board
/InputFrontend/IN2: J3.1; also elsewhere on the board
/MPU/I2C_SCL: J5.2, R9.2; also elsewhere on the board
/MPU/I2C_SDA: J5.5, R8.2; also elsewhere on the board
/OutputAmp/OUT: J4.1; also elsewhere on the board
/PowerInput/IN: J1.1; also elsewhere on the board
/USBSHIELD: C1.1, J6.SH (SHIELD), R13.1
GND: C1.2, C2.2, D1.2, D2.1, DS1.1, DS2.1, DS5.1, DS6.1, DS7.1, DZ1.2, J1.2, J2.2, J3.2, J4.2, J5.6, J6.5 (GND), MP1.1, MP2.1, MP3.1, MP4.1, R3.1, R4.1, R13.2, TP1.1, TP2.1, TP3.1; also elsewhere on the board
unnamed: DS1.2, R1.2
unnamed: DS2.2, R2.2
unnamed: DS3.2, R3.2
unnamed: DS4.2, R4.2
unnamed: DS5.2, R5.2
unnamed: DS6.2, R6.2
unnamed: DS7.2, R7.2
unnamed: J5.1, R12.2
unnamed: J5.3, R10.2
unnamed: J5.4, R11.2

Notes on the sheet:
PCB: 4-layer, ɛ approx= 3.66 Stackup: - 1oz/35µm copper outside, 0.5oz/17µm copper inside - prepreg: 200µm - core: 1.2mm Differential T-line Zdiff = 100, Z0 = 67 0.21 track, 0.16 space Use a recent devel version of KiCad with differential routing Single-ended T-line Z0 = 50 0.35 track
EMI Filtering
LEGEND
Arrows indicate direction of signal path
Double-struck wire indicates major signal path
Sinusoidal signal
Square signal
STANDARD PARTS, UNLESS LABELED:
Power supply status LEDs

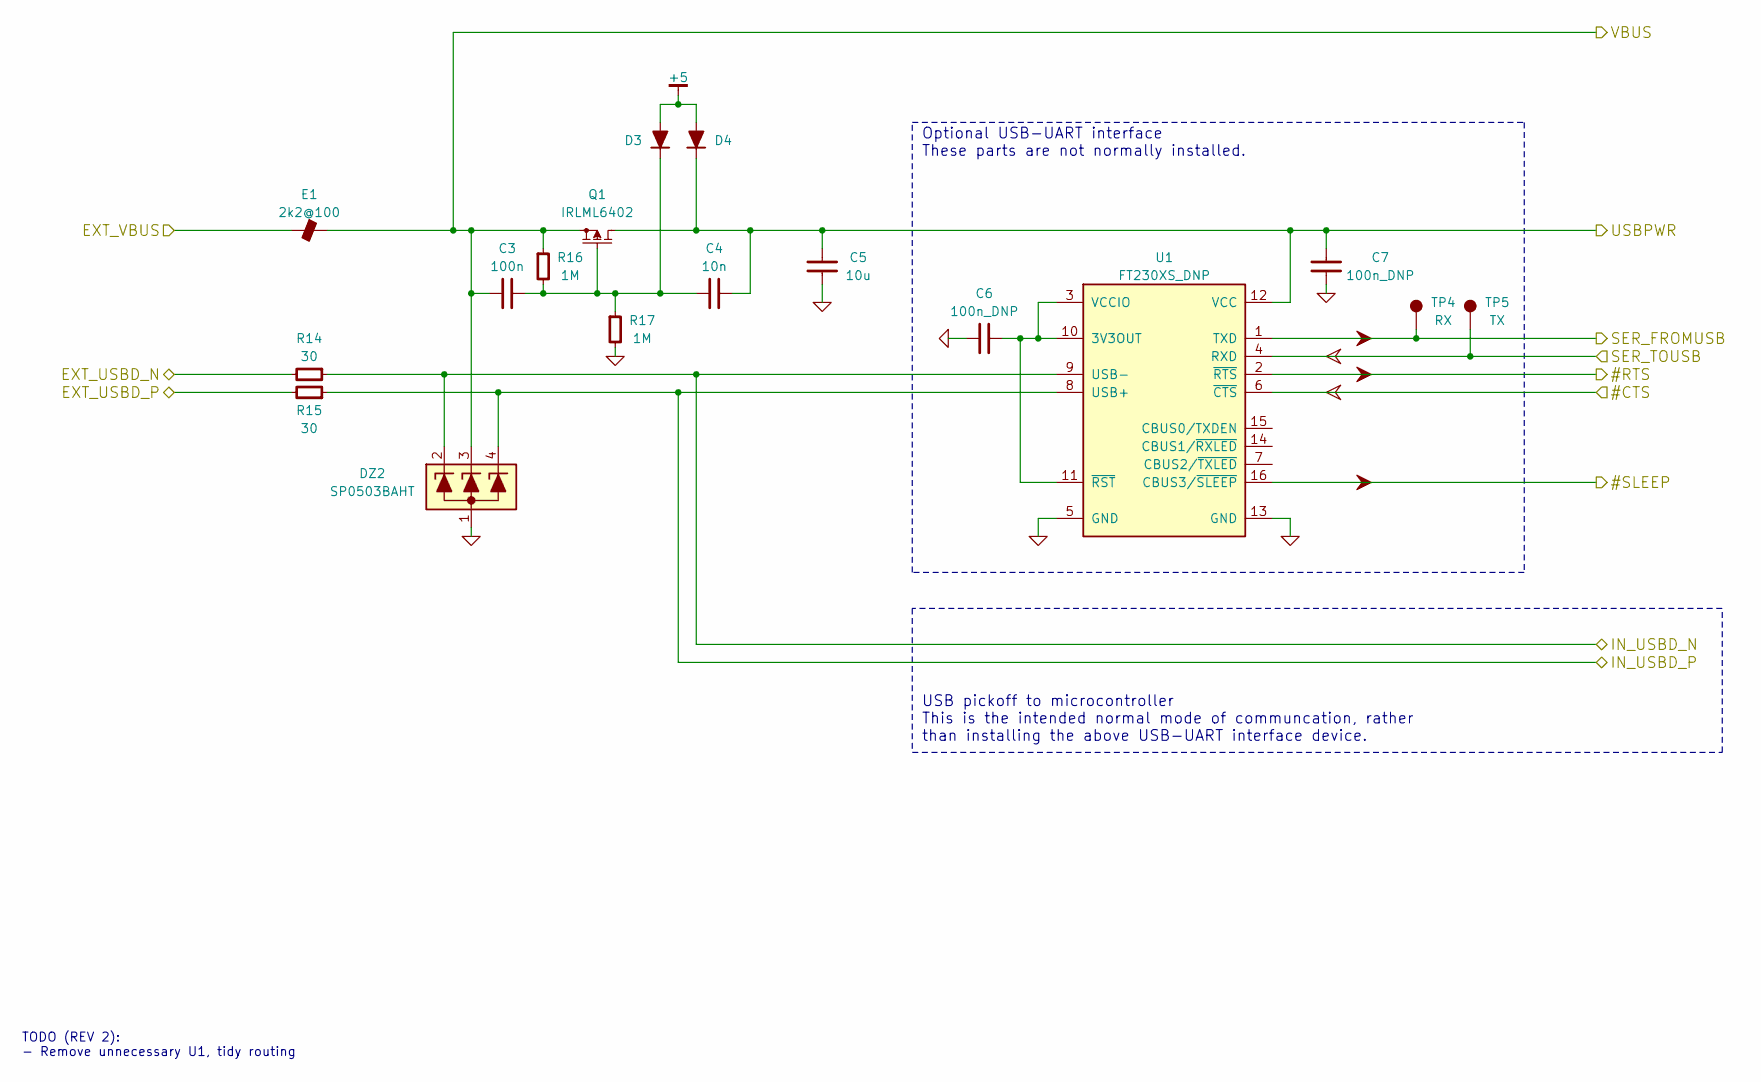
[picture p24: schematic Comm.sch, USB Communications]

Parts:
C3: 100n; CAPC1608X55
C4: 10n; CAPC1608X55
C5: 10u; CAPC2012X70
C6, C7: 100n_DNP; CAPC1608X55
D3, D4: MMBD4148; SOT-23
DZ2: SP0503BAHT; SOT-143
E1: 2k2@100; INDC2012X130
Q1: IRLML6402; SOT-23
R14, R15: 30; RESC1608X50
R16, R17: 1M; RESC1608X50
TP4: RX; TEST-SMD-SMALL
TP5: TX; TEST-SMD-SMALL
U1: FT230XS_DNP; SOP63P600X160-16

Connections:
+5: D3.1, D4.1; also elsewhere on the board
/Comm/#CTS: U1.6 (~CTS); also elsewhere on the board
/Comm/#RTS: U1.2 (~RTS); also elsewhere on the board
/Comm/#SLEEP: U1.16 (CBUS3/~SLEEP); also elsewhere on the board
/Comm/EXT_USBD_N: R14.2; also elsewhere on the board
/Comm/EXT_USBD_P: R15.2; also elsewhere on the board
/Comm/EXT_VBUS: E1.1; also elsewhere on the board
/Comm/IN_USBD_N: DZ2.2, R14.1, U1.9 (USB-); also elsewhere on the board
/Comm/IN_USBD_P: DZ2.4, R15.1, U1.8 (USB+); also elsewhere on the board
/Comm/SER_FROMUSB: TP4.1, U1.1 (TXD); also elsewhere on the board
/Comm/USBPWR: C4.1, C5.1, C7.2, D4.3, Q1.3, U1.12 (VCC); also elsewhere on the board
/Comm/VBUS: C3.2, DZ2.3, E1.2, Q1.2, R16.1; also elsewhere on the board
/MPU/SER_FROM_MPU: TP5.1, U1.4 (RXD); also elsewhere on the board
GND: C5.2, C6.2, C7.1, DZ2.1, R17.2, U1.5 (GND), U1.13 (GND); also elsewhere on the board
unnamed: C3.1, C4.2, D3.3, Q1.1, R16.2, R17.1
unnamed: C6.1, U1.3 (VCCIO), U1.10 (3V3OUT), U1.11 (~RST)

Notes on the sheet:
Optional USB-UART interface These parts are not normally installed.
USB pickoff to microcontroller This is the intended normal mode of communcation, rather than installing the above USB-UART interface device.
TODO (REV 2): - Remove unnecessary U1, tidy routing

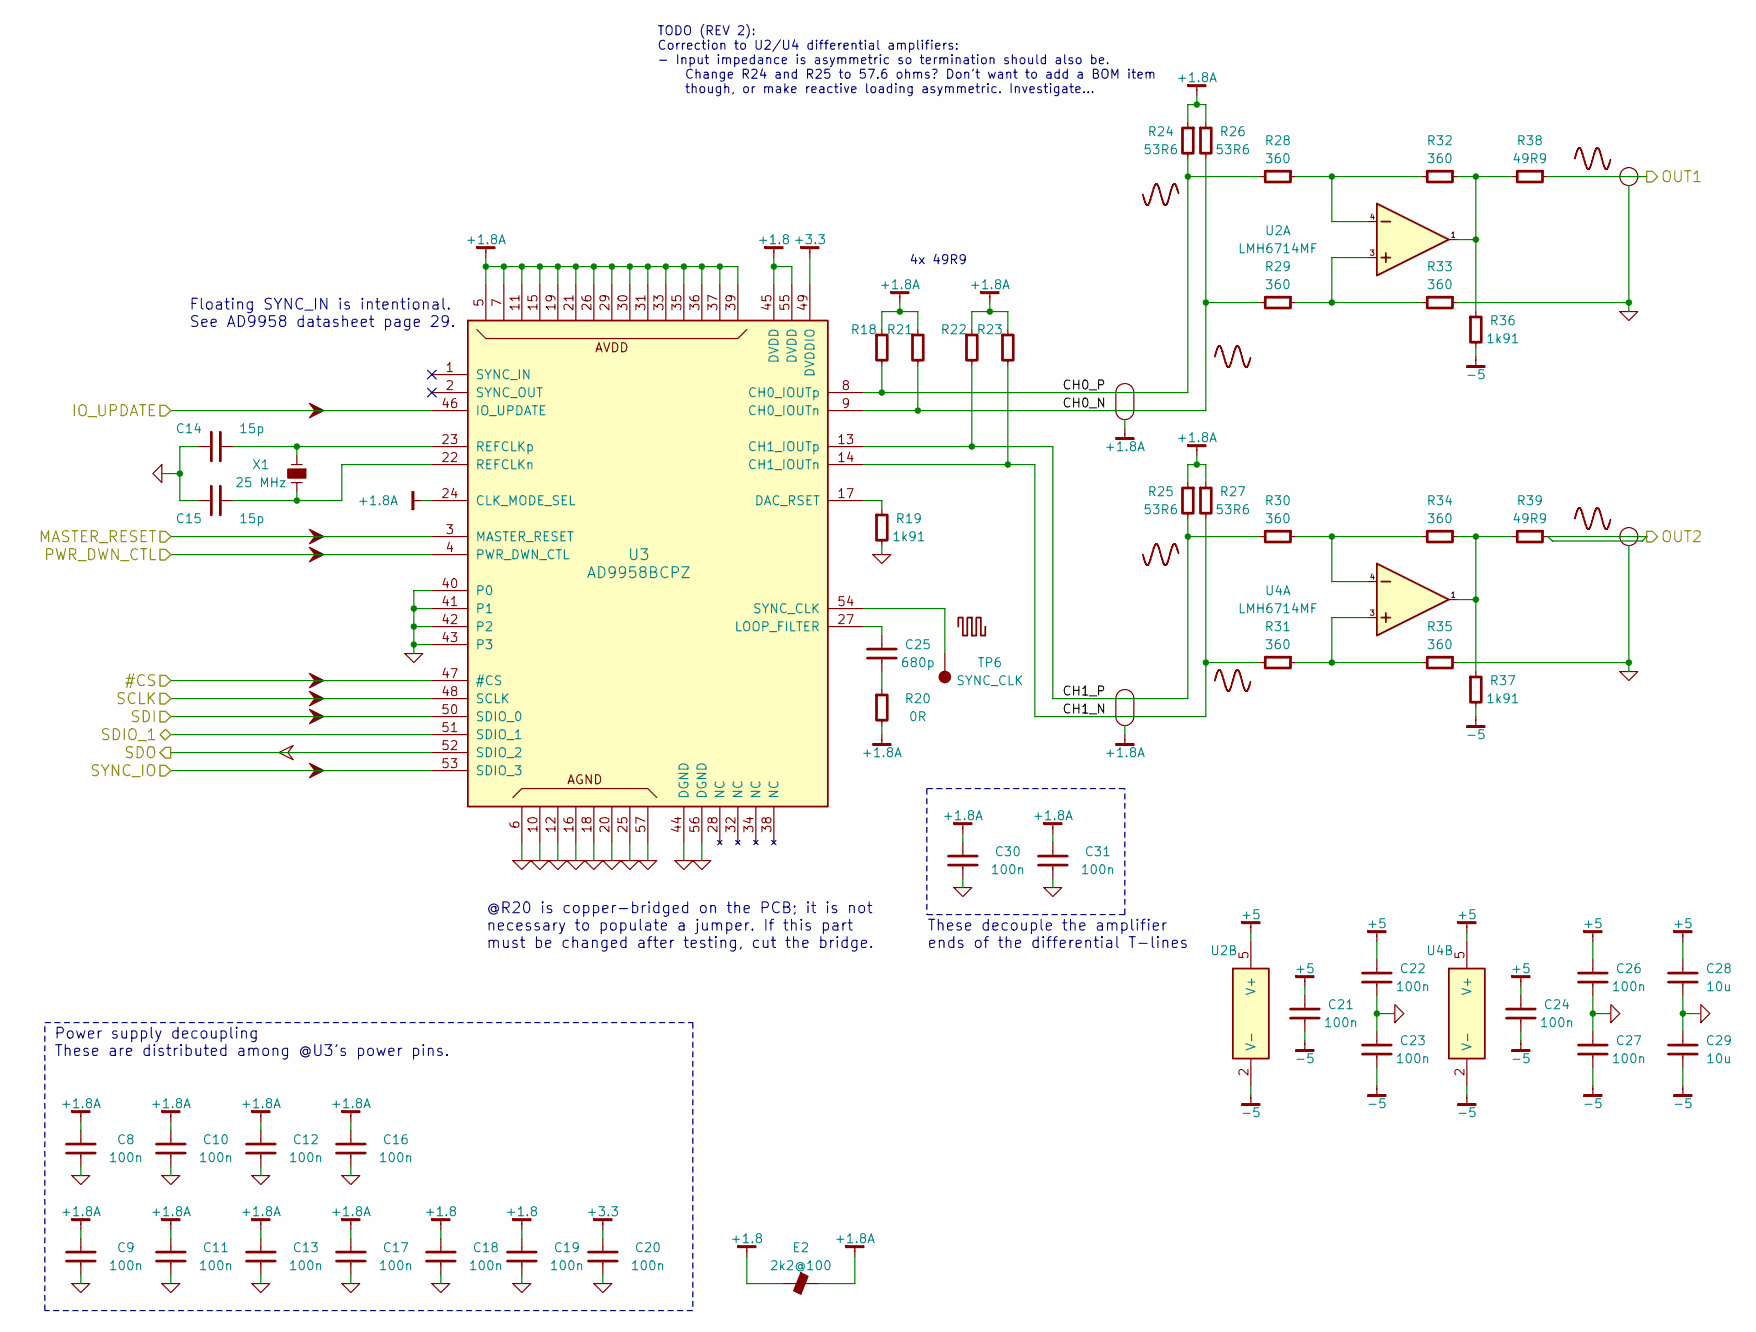
[picture p25: schematic Synth.sch, Synthesizer]

Parts:
C8, C9, C10, C11, C12, C13, C16, C17, C18, C19, C20, C22, C23, C26, C27, C30, C31: 100n; CAPC1608X55
C14, C15: 15p; CAPC1608X55
C21, C24: 100n; CAPC2012X70
C25: 680p; CAPC1608X55
C28, C29: 10u; CAPC2012X70
E2: 2k2@100; INDC2012X130
R18, R21, R22, R23, R38, R39: 49R9; RESC1608X50
R19, R36, R37: 1k91; RESC1608X50
R20: 0R; RESC1608X50
R24, R25, R26, R27: 53R6; RESC1608X50
R28, R29, R30, R31, R32, R33, R34, R35: 360; RESC1608X50
TP6: SYNC_CLK; TEST-SMD-SMALL
U2, U4: LMH6714MF; SOT-23-5
U3: AD9958BCPZ; ANALOG-LFCSP-VQ-56
X1: 25 MHz; XTAL1200X480X460

Connections:
+1.8: C18.1, C19.1, E2.1, U3.45 (DVDD), U3.55 (DVDD); also elsewhere on the board
+1.8A: C8.1, C9.1, C10.1, C11.1, C12.1, C13.1, C16.1, C17.1, C30.1, C31.1, E2.2, R18.1, R20.2, R21.1, R22.1, R23.1, R24.1, R25.1, R26.1, R27.1, U3.5 (AVDD), U3.7 (AVDD), U3.11 (AVDD), U3.15 (AVDD), U3.19 (AVDD), U3.21 (AVDD), U3.24 (CLK_MODE_SEL), U3.26 (AVDD), U3.29 (AVDD), U3.30 (AVDD), U3.31 (AVDD), U3.33 (AVDD), U3.35 (AVDD), U3.36 (AVDD), U3.37 (AVDD), U3.39 (AVDD)
+3.3: C20.1, U3.49 (DVDDIO); also elsewhere on the board
+5: C21.1, C22.1, C24.1, C26.1, C28.1, U2.5 (V+), U4.5 (V+); also elsewhere on the board
-5: C21.2, C23.2, C24.2, C27.2, C29.2, R36.2, R37.2, U2.2 (V-), U4.2 (V-); also elsewhere on the board
/OutputAmp/INPUT: R39.1; also elsewhere on the board
/Synth/#CS: U3.47 (#CS); also elsewhere on the board
/Synth/CH0_N: R21.2, R26.2, R29.2, U3.9 (CH0_IOUTn)
/Synth/CH0_P: R18.2, R24.2, R28.2, U3.8 (CH0_IOUTp)
/Synth/CH1_N: R23.2, R27.2, R31.2, U3.14 (CH1_IOUTn)
/Synth/CH1_P: R22.2, R25.2, R30.2, U3.13 (CH1_IOUTp)
/Synth/IO_UPDATE: U3.46 (IO_UPDATE); also elsewhere on the board
/Synth/MASTER_RESET: U3.3 (MASTER_RESET); also elsewhere on the board
/Synth/OUT1: R38.1; also elsewhere on the board
/Synth/PWR_DWN_CTL: U3.4 (PWR_DWN_CTL); also elsewhere on the board
/Synth/SCLK: U3.48 (SCLK); also elsewhere on the board
/Synth/SDI: U3.50 (SDIO_0); also elsewhere on the board
/Synth/SDIO_1: U3.51 (SDIO_1); also elsewhere on the board
/Synth/SDO: U3.52 (SDIO_2); also elsewhere on the board
/Synth/SYNC_IO: U3.53 (SDIO_3); also elsewhere on the board
GND: C8.2, C9.2, C10.2, C11.2, C12.2, C13.2, C14.2, C15.2, C16.2, C17.2, C18.2, C19.2, C20.2, C22.2, C23.1, C26.2, C27.1, C28.2, C29.1, C30.2, C31.2, R19.2, R33.1, R35.1, U3.6 (AGND), U3.10 (AGND), U3.12 (AGND), U3.16 (AGND), U3.18 (AGND), U3.20 (AGND), U3.25 (AGND), U3.40 (P0), U3.41 (P1), U3.42 (P2), U3.43 (P3), U3.44 (DGND), U3.56 (DGND), U3.57 (AGND); also elsewhere on the board
unnamed: C14.1, U3.23 (REFCLKp), X1.1
unnamed: C15.1, U3.22 (REFCLKn), X1.2
unnamed: C25.1, U3.27 (LOOP_FILTER)
unnamed: C25.2, R20.1
unnamed: R19.1, U3.17 (DAC_RSET)
unnamed: R28.1, R32.2, U2.4
unnamed: R29.1, R33.2, U2.3
unnamed: R30.1, R34.2, U4.4
unnamed: R31.1, R35.2, U4.3
unnamed: R32.1, R36.1, R38.2, U2.1
unnamed: R34.1, R37.1, R39.2, U4.1
unnamed: TP6.1, U3.54 (SYNC_CLK)

Notes on the sheet:
Floating SYNC_IN is intentional. See AD9958 datasheet page 29.
@R20 is copper-bridged on the PCB; it is not necessary to populate a jumper. If this part must be changed after testing, cut the bridge.
These decouple the amplifier ends of the differential T-lines
4x 49R9
Power supply decoupling These are distributed among @U3's power pins.
TODO (REV 2): Correction to U2/U4 differential amplifiers: - Input impedance is asymmetric so termination should also be. Change R24 and R25 to 57.6 ohms? Don't want to add a BOM item though, or make reactive loading asymmetric. Investigate...

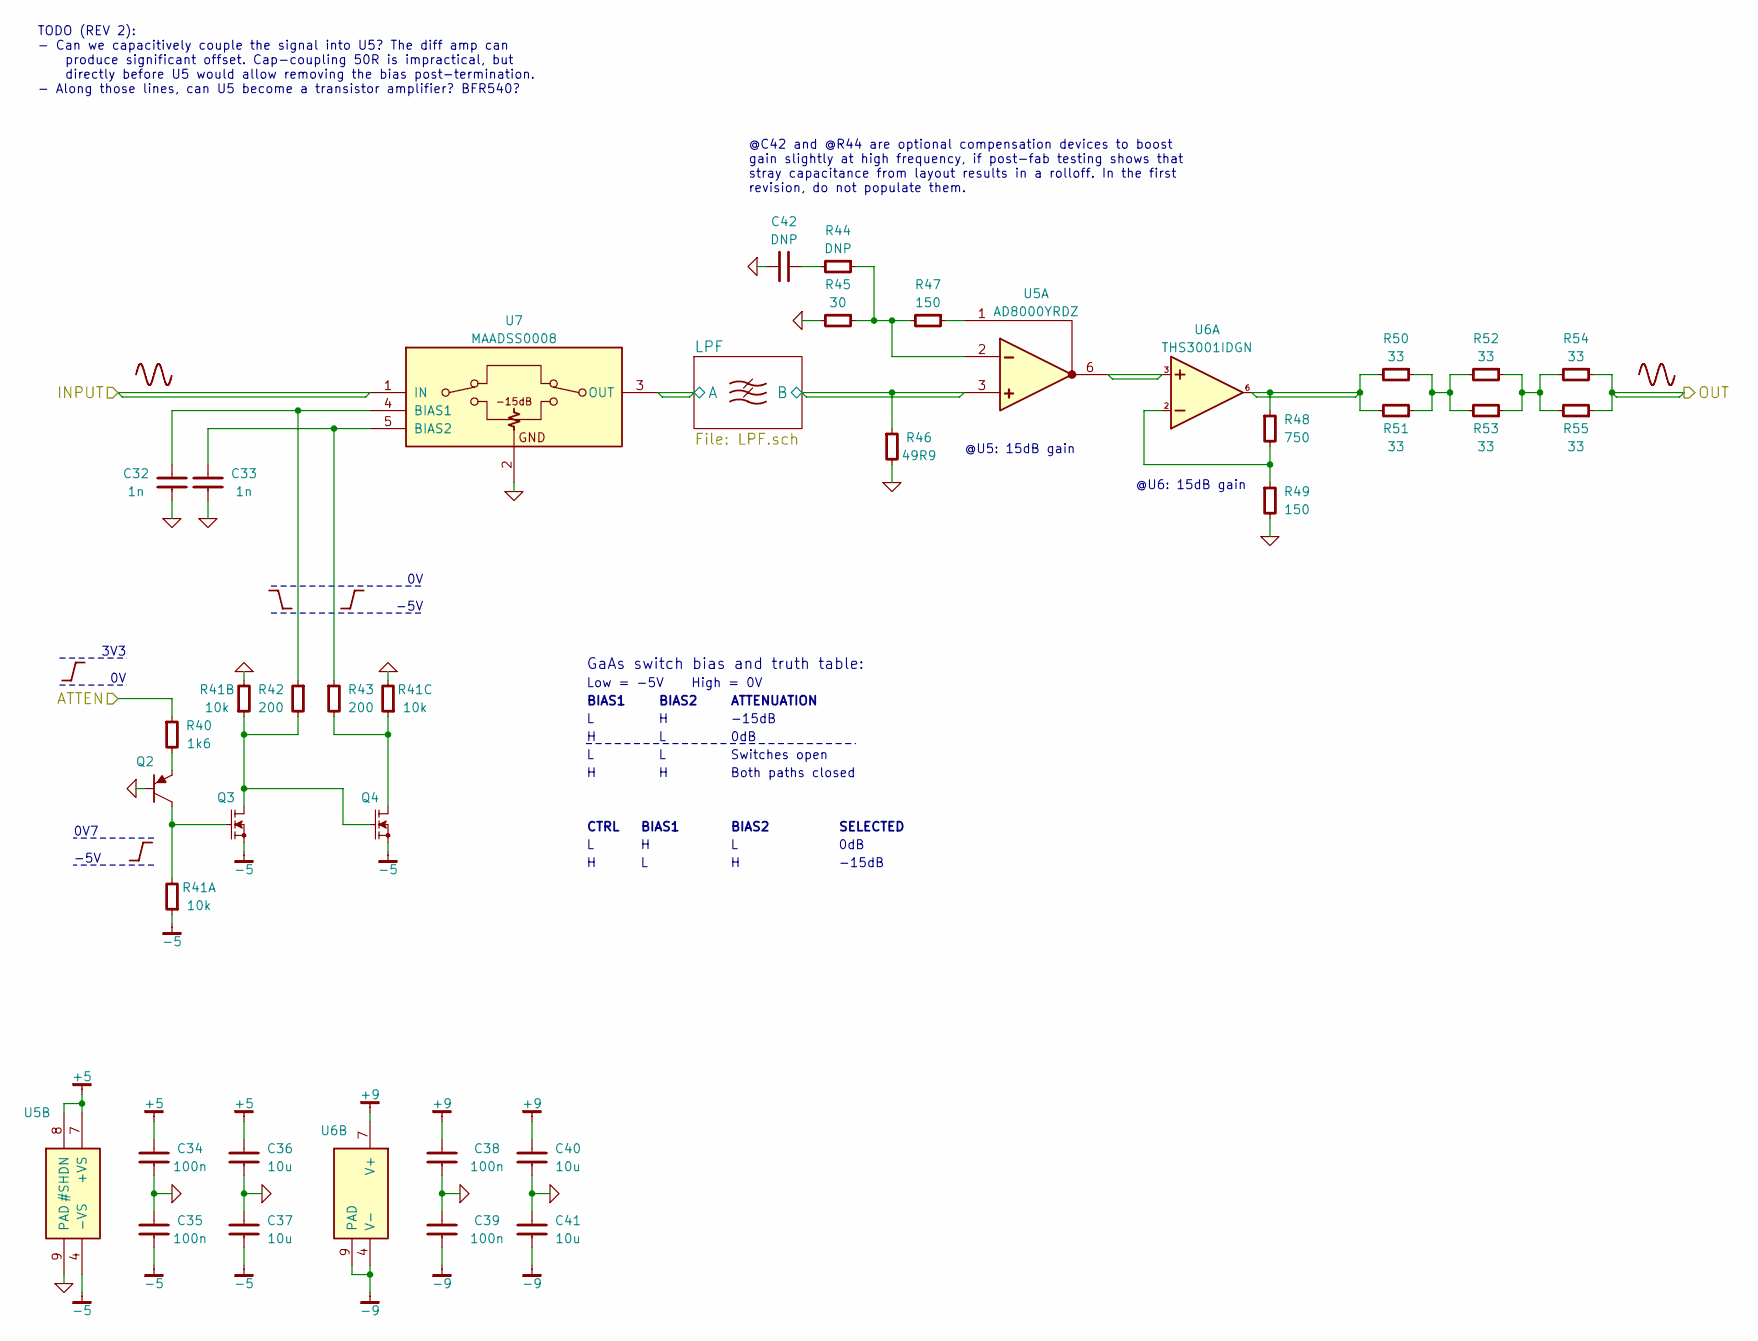
[picture p26: schematic OutputAmp.sch, Output Amplifier]

Parts:
C32, C33: 1n; CAPC1608X55
C34, C35: 100n; CAPC1608X55
C36, C37: 10u; CAPC2012X70
C38, C39: 100n; CAPC2012X70
C40, C41: 10u; CAPC3216X70
C42: DNP; CAPC1608X55
Q2: MMBT3906; SOT-23
Q3, Q4: 2N7002; SOT-23
R40: 1k6; RESC1608X50
R41: 10k; RESCAXE80P160X320X70-8
R42, R43: 200; RESC1608X50
R44: DNP; RESC1608X50
R45: 30; RESC1608X50
R46: 49R9; RESC1608X50
R47, R49: 150; RESC1608X50
R48: 750; RESC1608X50
R50, R51, R52, R53, R54, R55: 33; RESC1608X50
U5: AD8000YRDZ; SOIC127P600X175-9
U6: THS3001IDGN; SOP65P490X110-9A
U7: MAADSS0008; SOT-23-5

Connections:
+5: C34.1, C36.1, U5.7 (+VS), U5.8 (#SHDN); also elsewhere on the board
+9: C38.1, C40.1, U6.7 (V+); also elsewhere on the board
-5: C35.2, C37.2, Q3.2, Q4.2, R41.1, U5.4 (-VS); also elsewhere on the board
-9: C39.2, C41.2, U6.4 (V-), U6.9 (PAD); also elsewhere on the board
/MPU/ATTEN: R40.1; also elsewhere on the board
/OutputAmp/INPUT: U7.1 (IN); also elsewhere on the board
/OutputAmp/LPF/A: U7.3 (OUT); also elsewhere on the board
/OutputAmp/LPF/B: R46.1, U5.3; also elsewhere on the board
/OutputAmp/OUT: R54.1, R55.1; also elsewhere on the board
GND: C32.2, C33.2, C34.2, C35.1, C36.2, C37.1, C38.2, C39.1, C40.2, C41.1, C42.2, Q2.1, R41.6, R41.7, R45.2, R46.2, R49.2, U5.9 (PAD), U7.2; also elsewhere on the board
unnamed: C32.1, R42.1, U7.4 (BIAS1)
unnamed: C33.1, R43.1, U7.5 (BIAS2)
unnamed: C42.1, R44.2
unnamed: Q2.2, R40.2
unnamed: Q2.3, Q3.1, R41.8
unnamed: Q3.3, Q4.1, R41.2, R42.2
unnamed: Q4.3, R41.3, R43.2
unnamed: R44.1, R45.1, R47.2, U5.2
unnamed: R47.1, U5.1
unnamed: R48.1, R50.2, R51.2, U6.6
unnamed: R48.2, R49.1, U6.2
unnamed: R50.1, R51.1, R52.2, R53.2
unnamed: R52.1, R53.1, R54.2, R55.2
unnamed: U5.6, U6.3

Notes on the sheet:
@U5: 15dB gain
@U6: 15dB gain
@C42 and @R44 are optional compensation devices to boost gain slightly at high frequency, if post-fab testing shows that stray capacitance from layout results in a rolloff. In the first revision, do not populate them.
GaAs switch bias and truth table:
Low = -5V High = 0V
BIAS1
BIAS2
ATTENUATION
-15dB
0dB
Both paths closed
CTRL
SELECTED
Switches open
-5V
3V3
0V7
TODO (REV 2): - Can we capacitively couple the signal into U5? The diff amp can produce significant offset. Cap-coupling 50R is impractical, but directly before U5 would allow removing the bias post-termination. - Along those lines, can U5 become a transistor amplifier? BFR540?

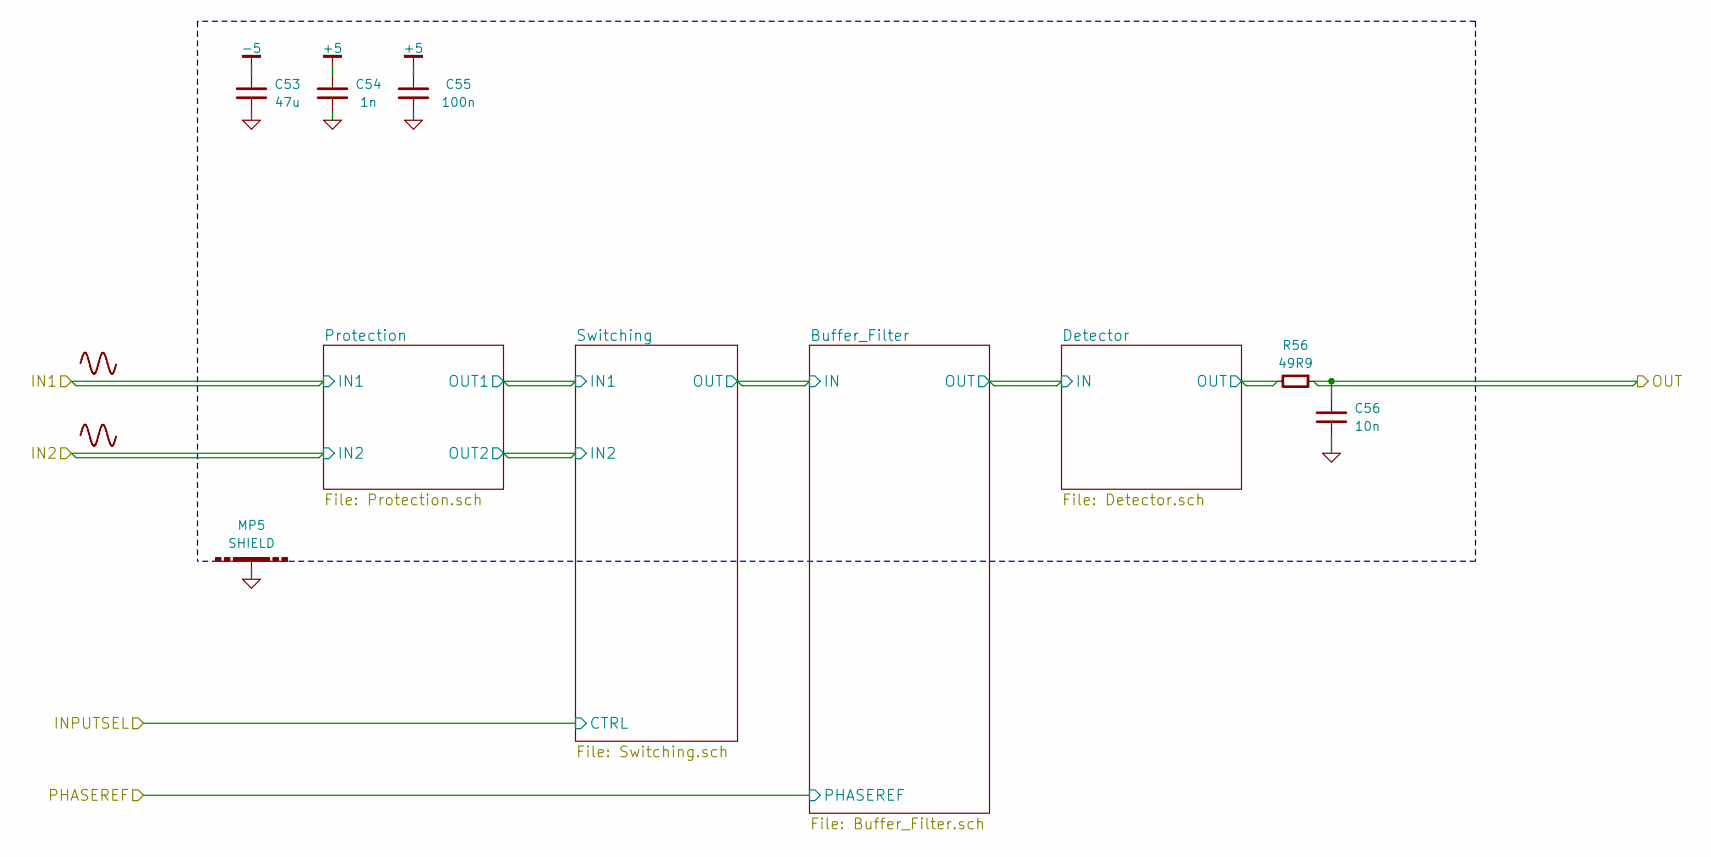
[picture p27: schematic InputFrontend.sch, Input Frontend]

Parts:
C53: 47u; CAPC3216X70
C54: 1n; CAPC1608X55
C55: 100n; CAPC2012X70
C56: 10n; CAPC1608X55
MP5: SHIELD; LAIRD-BMI-S-203
R56: 49R9; RESC1608X50

Connections:
+5: C54.1, C55.1; also elsewhere on the board
-5: C53.1; also elsewhere on the board
/InputFrontend/Detector/OUT: R56.2; also elsewhere on the board
/MPU/ADIN: C56.1, R56.1; also elsewhere on the board
GND: C53.2, C54.2, C55.2, C56.2, MP5.1; also elsewhere on the board

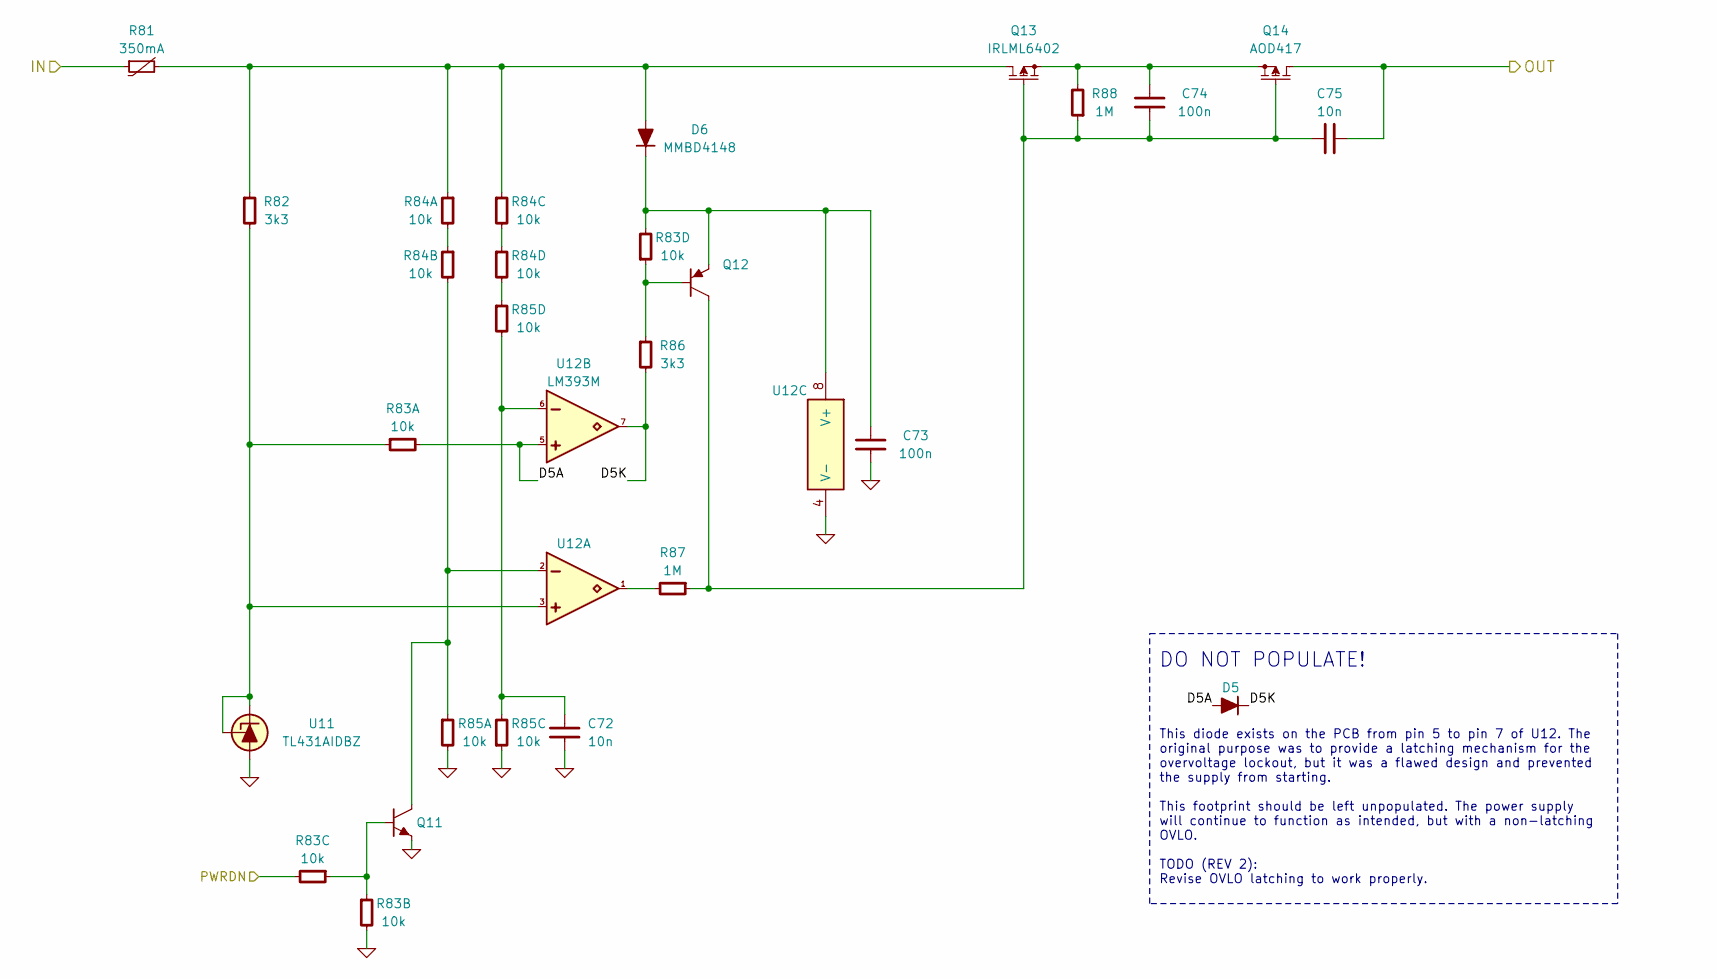
[picture p28: schematic PowerInput.sch, Power Input Circuit]

Parts:
C72, C75: 10n; CAPC1608X55
C73, C74: 100n; CAPC2012X70
D5, D6: MMBD4148; SOT-23
Q11: MMBT3904; SOT-23
Q12: MMBT3906; SOT-23
Q13: IRLML6402; SOT-23
Q14: AOD417; TO-252
R81: 350mA; RESC3216X60
R82, R86: 3k3; RESC1608X50
R83, R84, R85: 10k; RESCAXE80P160X320X70-8
R87, R88: 1M; RESC1608X50
U11: TL431AIDBZ; SOT-23
U12: LM393M; SOIC127P600X175-8

Connections:
/DCDC/IN: C75.1, Q14.3 (D); also elsewhere on the board
/MPU/PWRDN: R83.6; also elsewhere on the board
/PowerInput/D5A: D5.1, R83.8, U12.5
/PowerInput/D5K: D5.3, R86.2, U12.7
/PowerInput/IN: R81.1; also elsewhere on the board
GND: C72.2, C73.2, Q11.2, R83.7, R85.3, R85.8, U11.3, U12.4 (V-); also elsewhere on the board
unnamed: C72.1, R85.5, R85.6, U12.6
unnamed: C73.1, D6.3, Q12.2, R83.5, U12.8 (V+)
unnamed: C74.1, Q13.2, Q14.2 (S), R88.2
unnamed: C74.2, C75.2, Q12.3, Q13.1, Q14.1 (G), R87.1, R88.1
unnamed: D6.1, Q13.3, R81.2, R82.1, R84.1, R84.3
unnamed: Q11.1, R83.2, R83.3
unnamed: Q11.3, R84.7, R85.1, U12.2
unnamed: Q12.1, R83.4, R86.1
unnamed: R82.2, R83.1, U11.1, U11.2, U12.3
unnamed: R84.2, R84.8
unnamed: R84.4, R84.6
unnamed: R84.5, R85.4
unnamed: R87.2, U12.1

Notes on the sheet:
DO NOT POPULATE!
This diode exists on the PCB from pin 5 to pin 7 of U12. The original purpose was to provide a latching mechanism for the overvoltage lockout, but it was a flawed design and prevented the supply from starting. This footprint should be left unpopulated. The power supply will continue to function as 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

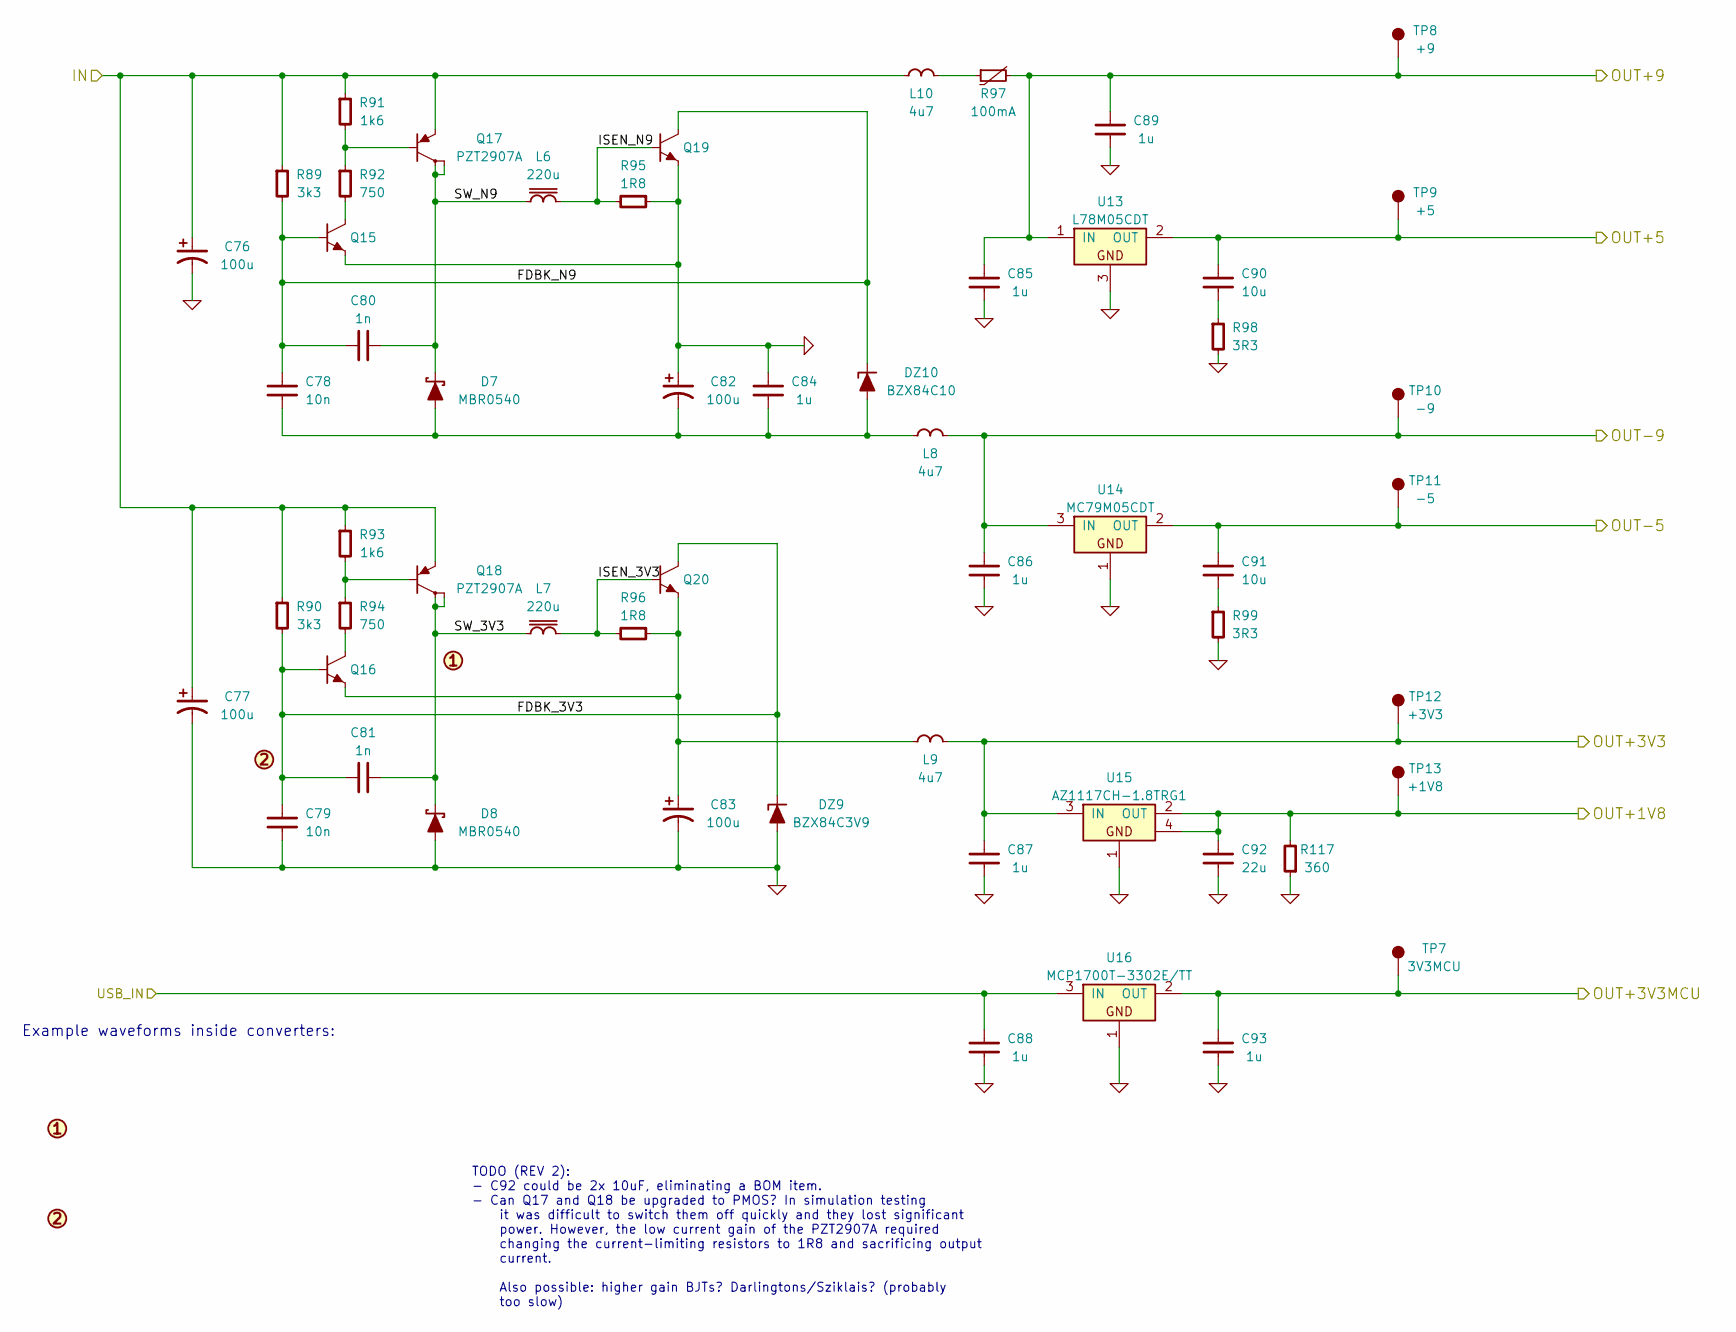
[picture p29: schematic DCDC.sch, DC-DC Converters]

Parts:
C76, C77, C82, C83: 100u; CAPAE660X570
C78, C79: 10n; CAPC1608X55
C80, C81: 1n; CAPC1608X55
C84, C85, C86, C87, C89: 1u; CAPC3216X70
C88, C93: 1u; CAPC2012X70
C90, C91: 10u; CAPC2012X70
C92: 22u; CAPC2012X70
D7, D8: MBR0540; SOD-123
DZ9: BZX84C3V9; SOT-23
DZ10: BZX84C10; SOT-23
L6, L7: 220u; BOURNS-RLB0914
L8, L9, L10: 4u7; INDC2012X130
Q15, Q16, Q19, Q20: MMBT3904; SOT-23
Q17, Q18: PZT2907A; SOT-223
R89, R90: 3k3; RESC1608X50
R91, R93: 1k6; RESC1608X50
R92, R94: 750; RESC1608X50
R95, R96: 1R8; RESC3225X60
R97: 100mA; RESC3216X60
R98, R99: 3R3; RESC1608X50
R117: 360; RESC1608X50
TP7: 3V3MCU; TEST-SMD-SMALL
TP8: +9; TEST-SMD-SMALL
TP9: +5; TEST-SMD-SMALL
TP10: -9; TEST-SMD-SMALL
TP11: -5; TEST-SMD-SMALL
TP12: +3V3; TEST-SMD-SMALL
TP13: +1V8; TEST-SMD-SMALL
U13: L78M05CDT; TO-252
U14: MC79M05CDT; TO-252
U15: AZ1117CH-1.8TRG1; SOT-223
U16: MCP1700T-3302E/TT; SOT-23

Connections:
+1.8: C92.1, R117.2, TP13.1, U15.2 (OUT), U15.4; also elsewhere on the board
+3.3: C87.1, L9.1, TP12.1, U15.3 (IN); also elsewhere on the board
+3.3SB: C93.1, TP7.1, U16.2 (OUT); also elsewhere on the board
+5: C90.1, TP9.1, U13.2 (OUT); also elsewhere on the board
+9: C85.1, C89.1, R97.2, TP8.1, U13.1 (IN); also elsewhere on the board
-5: C91.1, TP11.1, U14.2 (OUT); also elsewhere on the board
-9: C86.1, L8.1, TP10.1, U14.3 (IN); also elsewhere on the board
/Comm/USBPWR: C88.1, U16.3 (IN); also elsewhere on the board
/DCDC/FDBK_3V3: C79.1, C81.2, DZ9.3, Q16.1, Q20.3, R90.2
/DCDC/FDBK_N9: C78.1, C80.2, DZ10.3, Q15.1, Q19.3, R89.2
/DCDC/IN: C76.1, C77.1, L10.2, Q17.3, Q18.3, R89.1, R90.1, R91.1, R93.1; also elsewhere on the board
/DCDC/ISEN_3V3: L7.1, Q20.1, R96.2
/DCDC/ISEN_N9: L6.1, Q19.1, R95.2
/DCDC/SW_3V3: C81.1, D8.1, L7.2, Q18.2, Q18.4
/DCDC/SW_N9: C80.1, D7.1, L6.2, Q17.2, Q17.4
GND: C76.2, C77.2, C79.2, C82.1, C83.2, C84.1, C85.2, C86.2, C87.2, C88.2, C89.2, C92.2, C93.2, D8.2, DZ9.1, Q15.2, Q19.2, R95.1, R98.2, R99.2, R117.1, U13.3, U14.1, U15.1, U16.1; also elsewhere on the board
unnamed: C78.2, C82.2, C84.2, D7.2, DZ10.1, L8.2
unnamed: C83.1, L9.2, Q16.2, Q20.2, R96.1
unnamed: C90.2, R98.1
unnamed: C91.2, R99.1
unnamed: L10.1, R97.1
unnamed: Q15.3, R92.2
unnamed: Q16.3, R94.2
unnamed: Q17.1, R91.2, R92.1
unnamed: Q18.1, R93.2, R94.1

Notes on the sheet:
Example waveforms inside converters:
TODO (REV 2): - C92 could be 2x 10uF, eliminating a BOM item. - Can Q17 and Q18 be upgraded to PMOS? In simulation testing it was difficult to switch them off quickly and they lost significant power. However, the low current gain of the PZT2907A required changing the current-limiting resistors to 1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
