WCP52/gpha/PCB/wcp52/wcp52.kicad_pcb

## KiCad design PCB/wcp52/wcp52.kicad_pcb (continued)

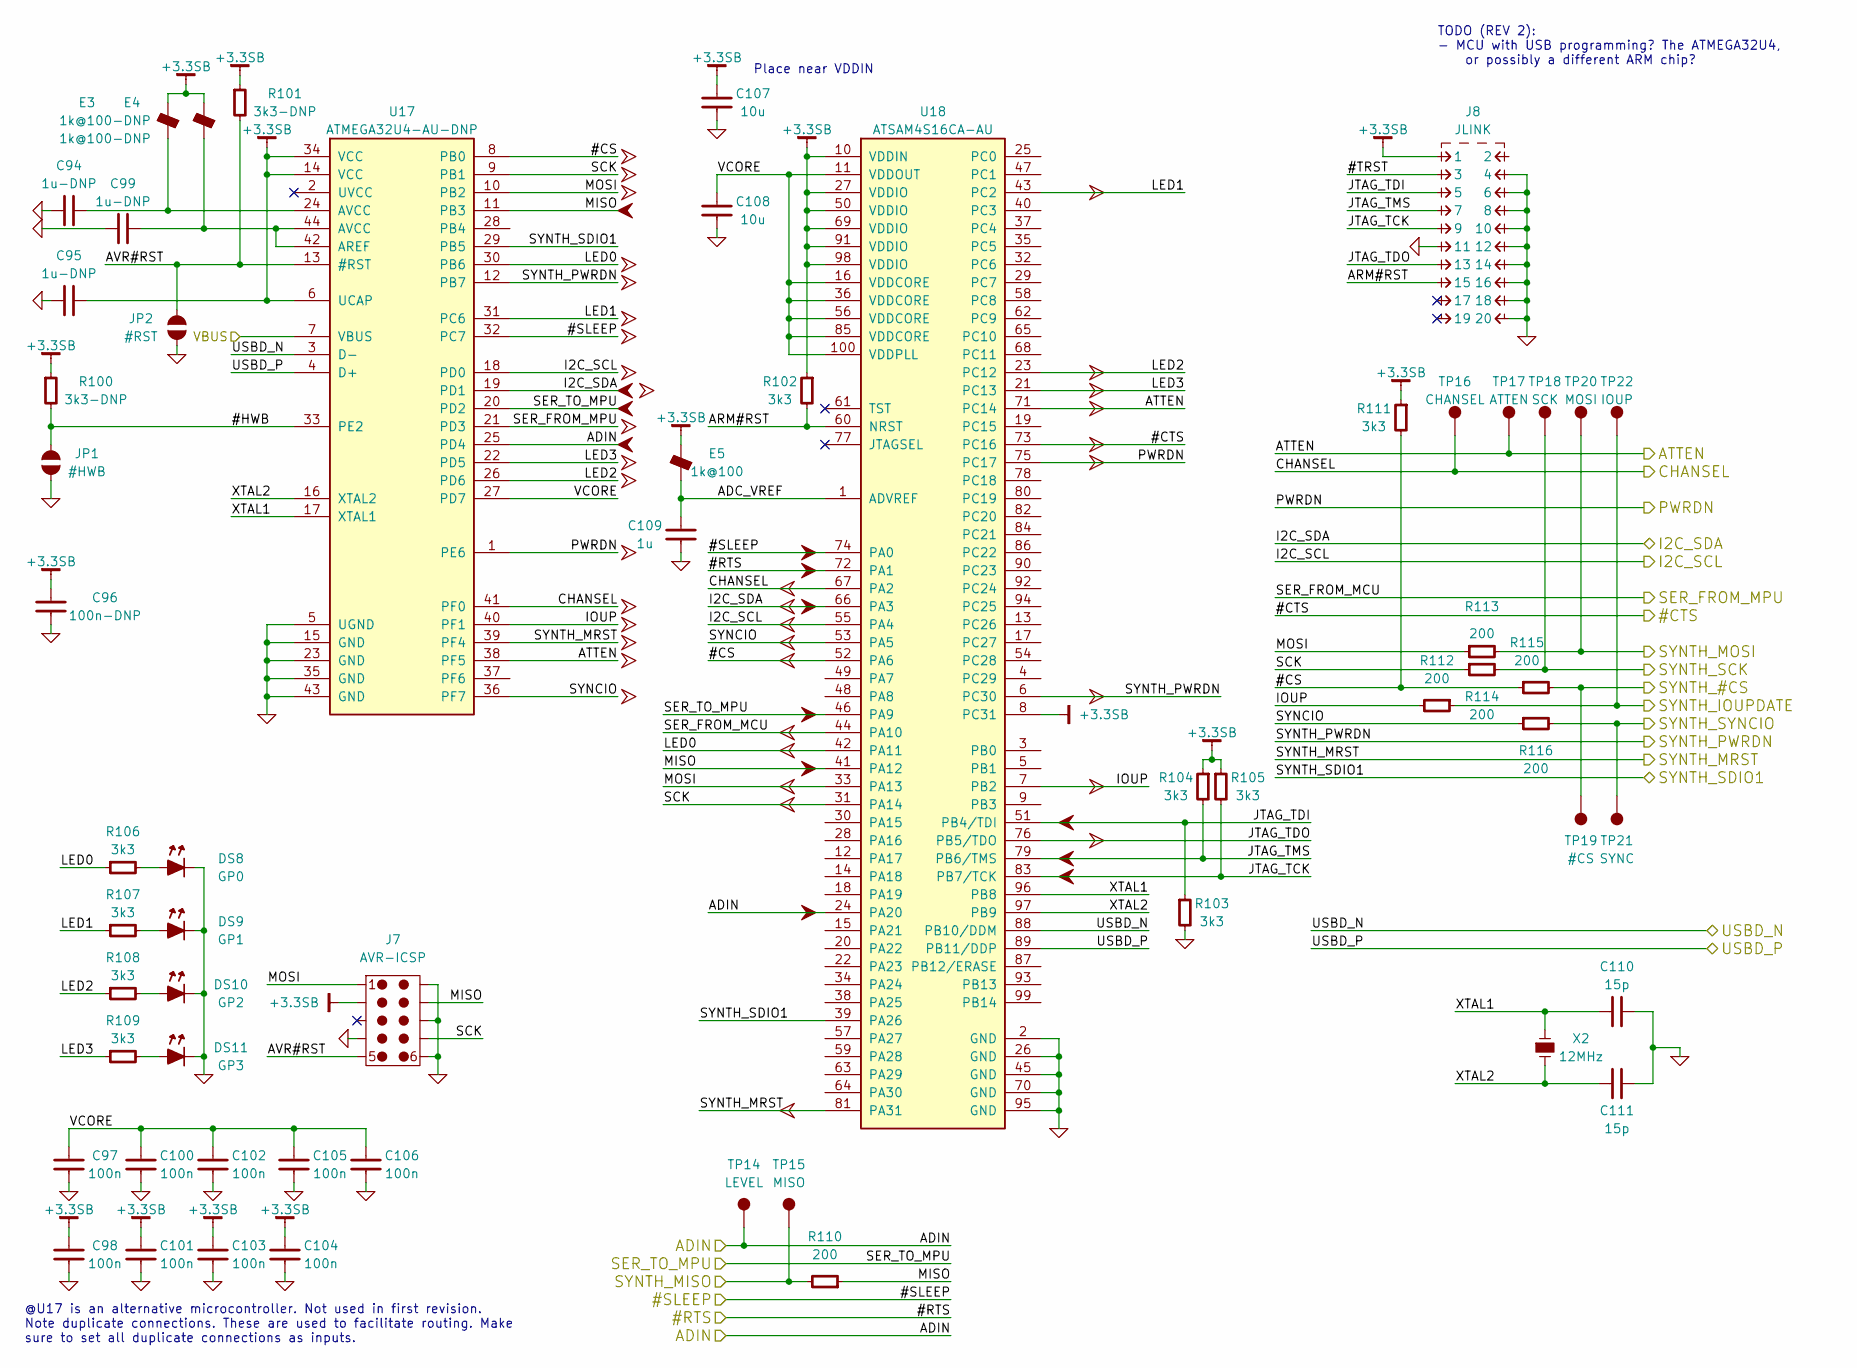
[picture p30: schematic MPU.sch]

Parts:
C94, C95, C99: 1u-DNP; CAPC2012X70
C96: 100n-DNP; CAPC1608X55
C97, C98, C100, C101, C102, C103, C104, C105, C106: 100n; CAPC1608X55
C107, C108: 10u; CAPC2012X70
C109: 1u; CAPC2012X70
C110, C111: 15p; CAPC1608X55
DS8: GP0; LED-0603
DS9: GP1; LED-0603
DS10: GP2; LED-0603
DS11: GP3; LED-0603
E3, E4: 1k@100-DNP; INDC1608X95
E5: 1k@100; INDC1608X95
J7: AVR-ICSP; TAGCONNECT-TC2050
J8: JLINK; CONN-100MIL-M-2x10-SHROUD
JP1: #HWB
JP2: #RST
R100, R101: 3k3-DNP; RESC1608X50
R102, R103, R104, R105, R106, R107, R108, R109, R111: 3k3; RESC1608X50
R110, R112, R113, R114, R115, R116: 200; RESC1608X50
TP14: LEVEL; TEST-SMD-SMALL
TP15: MISO; TEST-SMD-SMALL
TP16: CHANSEL; TEST-SMD-SMALL
TP17: ATTEN; TEST-SMD-SMALL
TP18: SCK; TEST-SMD-SMALL
TP19: #CS; TEST-SMD-SMALL
TP20: MOSI; TEST-SMD-SMALL
TP21: SYNC; TEST-SMD-SMALL
TP22: IOUP; TEST-SMD-SMALL
U17: ATMEGA32U4-AU-DNP; QFP80P1200X1200X120-44
U18: ATSAM4S16CA-AU; QFP50P1600X1600X160-100
X2: 12MHz; XTAL1200X480X460

Connections:
+3.3SB: C95.1, C96.1, C98.1, C101.1, C103.1, C104.1, C107.1, E3.1, E4.1, E5.1, J7.2, J8.1, R100.1, R101.1, R102.1, R104.1, R105.1, R111.1, U17.6 (UCAP), U17.14 (VCC), U17.34 (VCC), U18.8 (PC31), U18.10 (VDDIN), U18.27 (VDDIO), U18.50 (VDDIO), U18.69 (VDDIO), U18.91 (VDDIO), U18.98 (VDDIO); also elsewhere on the board
/Comm/#CTS: U18.73 (PC16); also elsewhere on the board
/Comm/#RTS: U18.72 (PA1); also elsewhere on the board
/Comm/#SLEEP: U17.32 (PC7), U18.74 (PA0); also elsewhere on the board
/Comm/IN_USBD_N: U17.3 (D-), U18.88 (PB10/DDM); also elsewhere on the board
/Comm/IN_USBD_P: U17.4 (D+), U18.89 (PB11/DDP); also elsewhere on the board
/Comm/SER_FROMUSB: U17.20 (PD2), U18.46 (PA9); also elsewhere on the board
/Comm/VBUS: U17.7 (VBUS); also elsewhere on the board
/MPU/#CS: R111.2, R115.1, U17.8 (PB0), U18.52 (PA6)
/MPU/#HWB: JP1.1, R100.2, U17.33 (PE2)
/MPU/#TRST: J8.3
/MPU/ADC_VREF: C109.1, E5.2, U18.1 (ADVREF)
/MPU/ADIN: TP14.1, U17.25 (PD4), U18.24 (PA20); also elsewhere on the board
/MPU/ARM#RST: J8.15, R102.2, U18.60 (NRST)
/MPU/ATTEN: TP17.1, U17.38 (PF5), U18.71 (PC14); also elsewhere on the board
/MPU/AVR#RST: J7.5, JP2.1, R101.2, U17.13 (#RST)
/MPU/CHANSEL: TP16.1, U17.41 (PF0), U18.67 (PA2); also elsewhere on the board
/MPU/I2C_SCL: U17.18 (PD0), U18.55 (PA4); also elsewhere on the board
/MPU/I2C_SDA: U17.19 (PD1), U18.66 (PA3); also elsewhere on the board
/MPU/IOUP: R112.2, U17.40 (PF1), U18.7 (PB2)
/MPU/JTAG_TCK: J8.9, R105.2, U18.83 (PB7/TCK)
/MPU/JTAG_TDI: J8.5, R103.1, U18.51 (PB4/TDI)
/MPU/JTAG_TDO: J8.13, U18.76 (PB5/TDO)
/MPU/JTAG_TMS: J8.7, R104.2, U18.79 (PB6/TMS)
/MPU/LED0: R106.1, U17.30 (PB6), U18.42 (PA11)
/MPU/LED1: R107.1, U17.31 (PC6), U18.43 (PC2)
/MPU/LED2: R108.1, U17.26 (PD6), U18.23 (PC12)
/MPU/LED3: R109.1, U17.22 (PD5), U18.21 (PC13)
/MPU/MISO: J7.9, R110.1, U17.11 (PB3), U18.41 (PA12)
/MPU/MOSI: J7.1, R113.1, U17.10 (PB2), U18.33 (PA13)
/MPU/PWRDN: U17.1 (PE6), U18.75 (PC17); also elsewhere on the board
/MPU/SCK: J7.7, R114.1, U17.9 (PB1), U18.31 (PA14)
/MPU/SER_FROM_MPU: U17.21 (PD3), U18.44 (PA10); also elsewhere on the board
/MPU/SYNCIO: R116.1, U17.36 (PF7), U18.53 (PA5)
/MPU/VCORE: C97.1, C100.1, C102.1, C105.1, C106.1, C108.1, U17.27 (PD7), U18.11 (VDDOUT), U18.16 (VDDCORE), U18.36 (VDDCORE), U18.56 (VDDCORE), U18.85 (VDDCORE), U18.100 (VDDPLL)
/MPU/XTAL1: C110.2, U17.17 (XTAL1), U18.96 (PB8), X2.1
/MPU/XTAL2: C111.2, U17.16 (XTAL2), U18.97 (PB9), X2.2
/Synth/#CS: R115.2, TP19.1; also elsewhere on the board
/Synth/IO_UPDATE: R112.1, TP22.1; also elsewhere on the board
/Synth/MASTER_RESET: U17.39 (PF4), U18.81 (PA31); also elsewhere on the board
/Synth/PWR_DWN_CTL: U17.12 (PB7), U18.6 (PC30); also elsewhere on the board
/Synth/SCLK: R114.2, TP18.1; also elsewhere on the board
/Synth/SDI: R113.2, TP20.1; also elsewhere on the board
/Synth/SDIO_1: U17.29 (PB5), U18.39 (PA26); also elsewhere on the board
/Synth/SDO: R110.2, TP15.1; also elsewhere on the board
/Synth/SYNC_IO: R116.2, TP21.1; also elsewhere on the board
GND: C94.2, C95.2, C96.2, C97.2, C98.2, C99.2, C100.2, C101.2, C102.2, C103.2, C104.2, C105.2, C106.2, C107.2, C108.2, C109.2, C110.1, C111.1, DS8.1, DS9.1, DS10.1, DS11.1, J7.4, J7.6, J7.8, J7.10, J8.4, J8.6, J8.8, J8.10, J8.11, J8.12, J8.14, J8.16, J8.18, J8.20, JP1.2, JP2.2, R103.2, U17.5 (UGND), U17.15 (GND), U17.23 (GND), U17.35 (GND), U17.43 (GND), U18.2 (GND), U18.26 (GND), U18.45 (GND), U18.70 (GND), U18.95 (GND); also elsewhere on the board
unnamed: C94.1, E3.2, U17.24 (AVCC)
unnamed: C99.1, E4.2, U17.42 (AREF), U17.44 (AVCC)
unnamed: DS8.2, R106.2
unnamed: DS9.2, R107.2
unnamed: DS10.2, R108.2
unnamed: DS11.2, R109.2

Notes on the sheet:
Place near VDDIN
@U17 is an alternative microcontroller. Not used in first revision. Note duplicate connections. These are used to facilitate routing. Make sure to set all duplicate connections as inputs.
TODO (REV 2): - MCU with USB programming? The ATMEGA32U4, or possibly a different ARM chip?

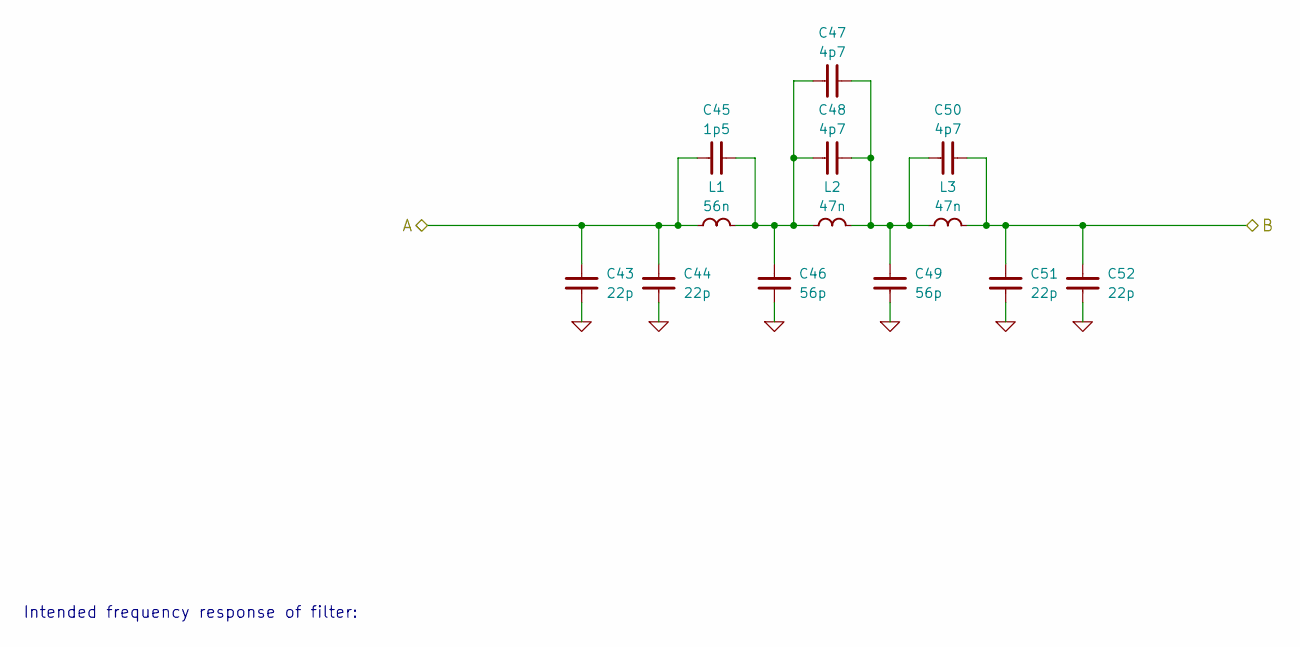
[picture p31: schematic LPF.sch, LPF for Output Amplifier]

Parts:
C43, C44, C51, C52: 22p; CAPC1005X55
C45: 1p5; CAPC1005X55
C46, C49: 56p; CAPC1005X55
C47, C48, C50: 4p7; CAPC1005X55
L1: 56n; INDC1005X60
L2, L3: 47n; INDC1005X60

Connections:
/OutputAmp/LPF/A: C43.1, C44.1, C45.2, L1.2; also elsewhere on the board
/OutputAmp/LPF/B: C50.1, C51.1, C52.1, L3.1; also elsewhere on the board
GND: C43.2, C44.2, C46.2, C49.2, C51.2, C52.2; also elsewhere on the board
unnamed: C45.1, C46.1, C47.2, C48.2, L1.1, L2.2
unnamed: C47.1, C48.1, C49.1, C50.2, L2.1, L3.2

Notes on the sheet:
Intended frequency response of filter:

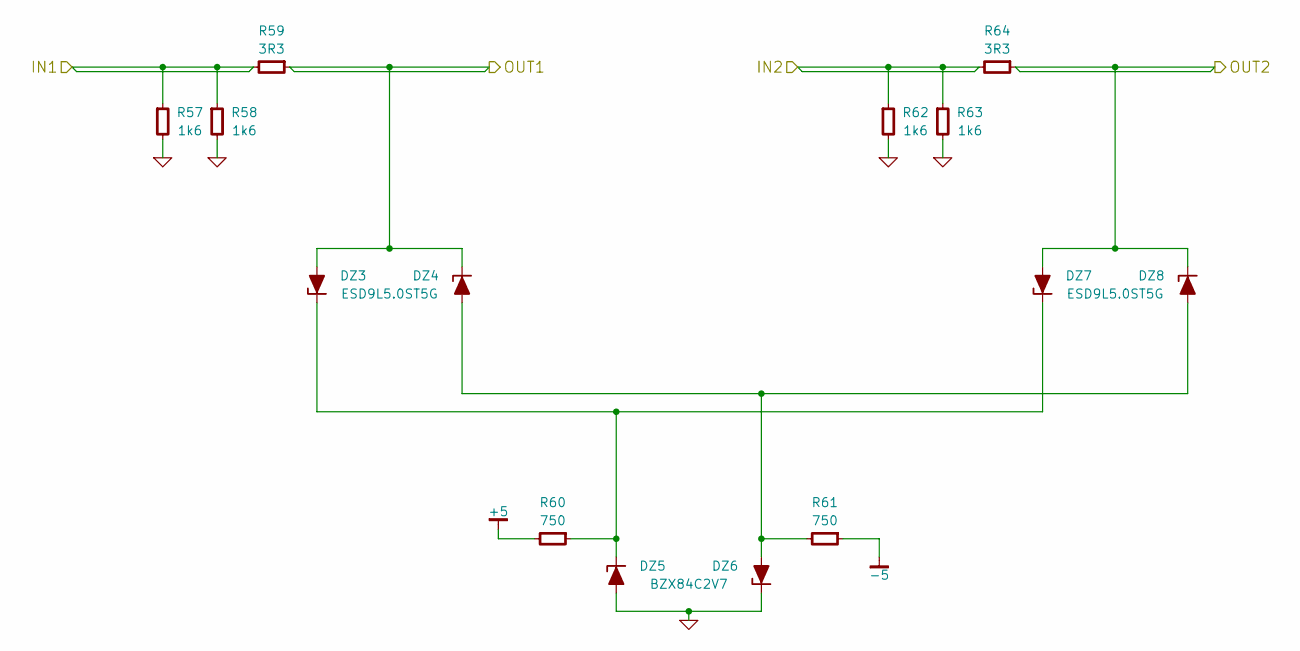
[picture p32: schematic Protection.sch, Input Protection]

Parts:
DZ3, DZ4, DZ7, DZ8: ESD9L5.0ST5G; SOD-923
DZ5, DZ6: BZX84C2V7; SOT-23
R57, R58, R62, R63: 1k6; RESC1608X50
R59, R64: 3R3; RESC1608X50
R60, R61: 750; RESC1608X50

Connections:
+5: R60.2; also elsewhere on the board
-5: R61.1; also elsewhere on the board
/InputFrontend/IN1: R57.1, R58.1, R59.2; also elsewhere on the board
/InputFrontend/IN2: R62.1, R63.1, R64.2; also elsewhere on the board
/InputFrontend/Switching/IN1: DZ3.2, DZ4.1, R59.1; also elsewhere on the board
/InputFrontend/Switching/IN2: DZ7.2, DZ8.1, R64.1; also elsewhere on the board
GND: DZ5.1, DZ6.3, R57.2, R58.2, R62.2, R63.2; also elsewhere on the board
unnamed: DZ3.1, DZ5.3, DZ7.1, R60.1
unnamed: DZ4.2, DZ6.1, DZ8.2, R61.2

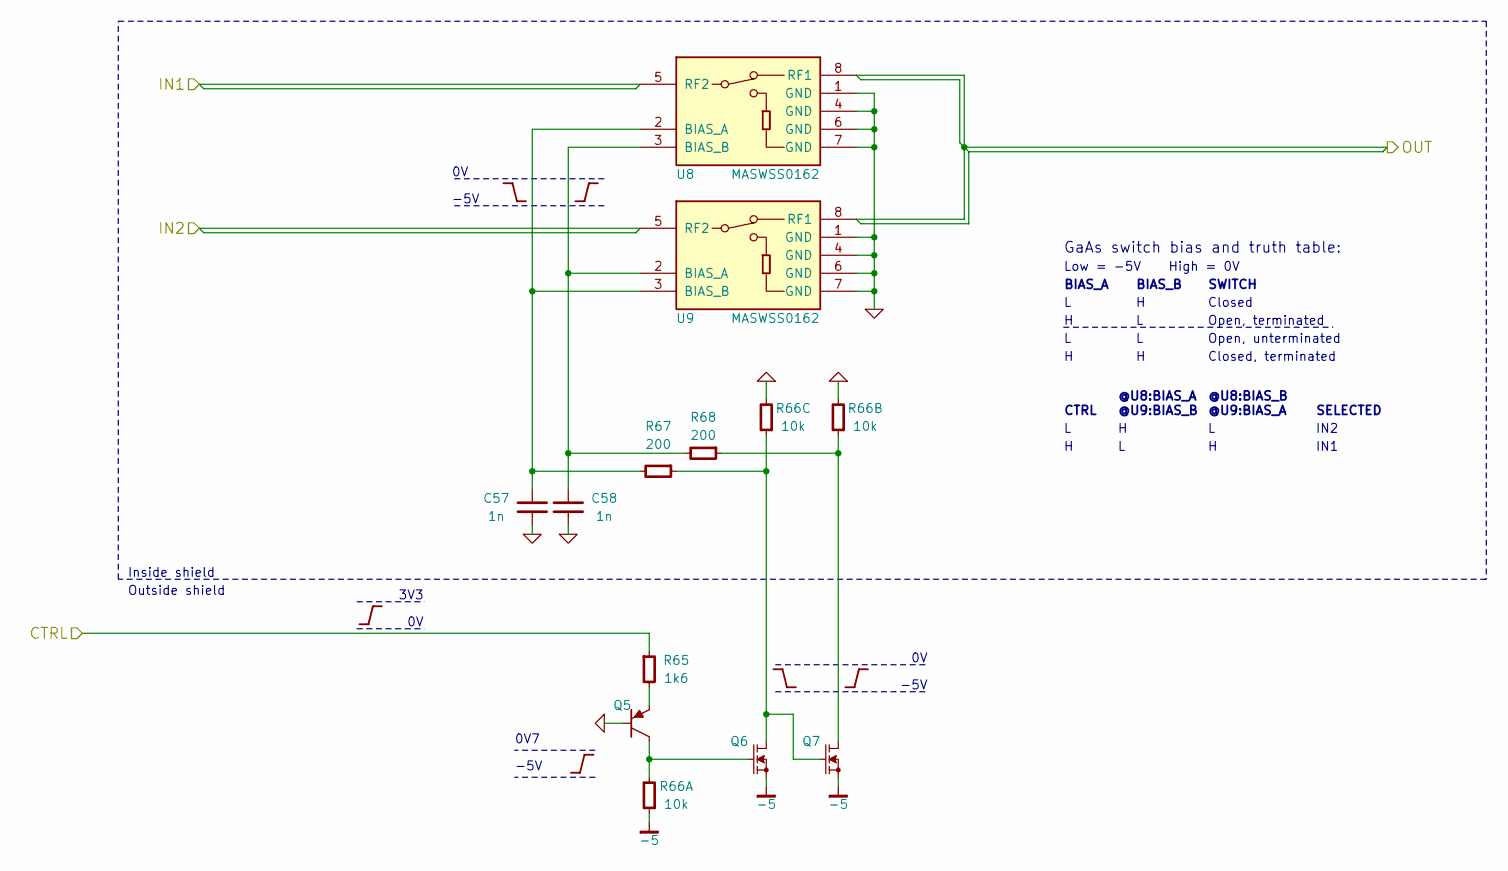
[picture p33: schematic Switching.sch, Input Switching]

Parts:
C57, C58: 1n; CAPC1608X55
Q5: MMBT3906; SOT-23
Q6, Q7: 2N7002; SOT-23
R65: 1k6; RESC1608X50
R66: 10k; RESCAXE80P160X320X70-8
R67, R68: 200; RESC1608X50
U8, U9: MASWSS0162; SOIC127P600X175-8

Connections:
-5: Q6.2, Q7.2, R66.1; also elsewhere on the board
/InputFrontend/Buffer_Filter/IN: U8.8 (RF1), U9.8 (RF1); also elsewhere on the board
/InputFrontend/Switching/IN1: U8.5 (RF2); also elsewhere on the board
/InputFrontend/Switching/IN2: U9.5 (RF2); also elsewhere on the board
/MPU/CHANSEL: R65.1; also elsewhere on the board
GND: C57.2, C58.2, Q5.1, R66.6, R66.7, U8.1 (GND), U8.4 (GND), U8.6 (GND), U8.7 (GND), U9.1 (GND), U9.4 (GND), U9.6 (GND), U9.7 (GND); also elsewhere on the board
unnamed: C57.1, R67.2, U8.2 (BIAS_A), U9.3 (BIAS_B)
unnamed: C58.1, R68.2, U8.3 (BIAS_B), U9.2 (BIAS_A)
unnamed: Q5.2, R65.2
unnamed: Q5.3, Q6.1, R66.8
unnamed: Q6.3, Q7.1, R66.3, R67.1
unnamed: Q7.3, R66.2, R68.1

Notes on the sheet:
Inside shield
Outside shield
GaAs switch bias and truth table:
-5V
3V3
0V7
Low = -5V High = 0V
BIAS_A
BIAS_B
SWITCH
Closed
Open, terminated
Open, unterminated
Closed, terminated
CTRL
@U8:BIAS_A @U9:BIAS_B
@U8:BIAS_B @U9:BIAS_A
SELECTED
IN2
IN1

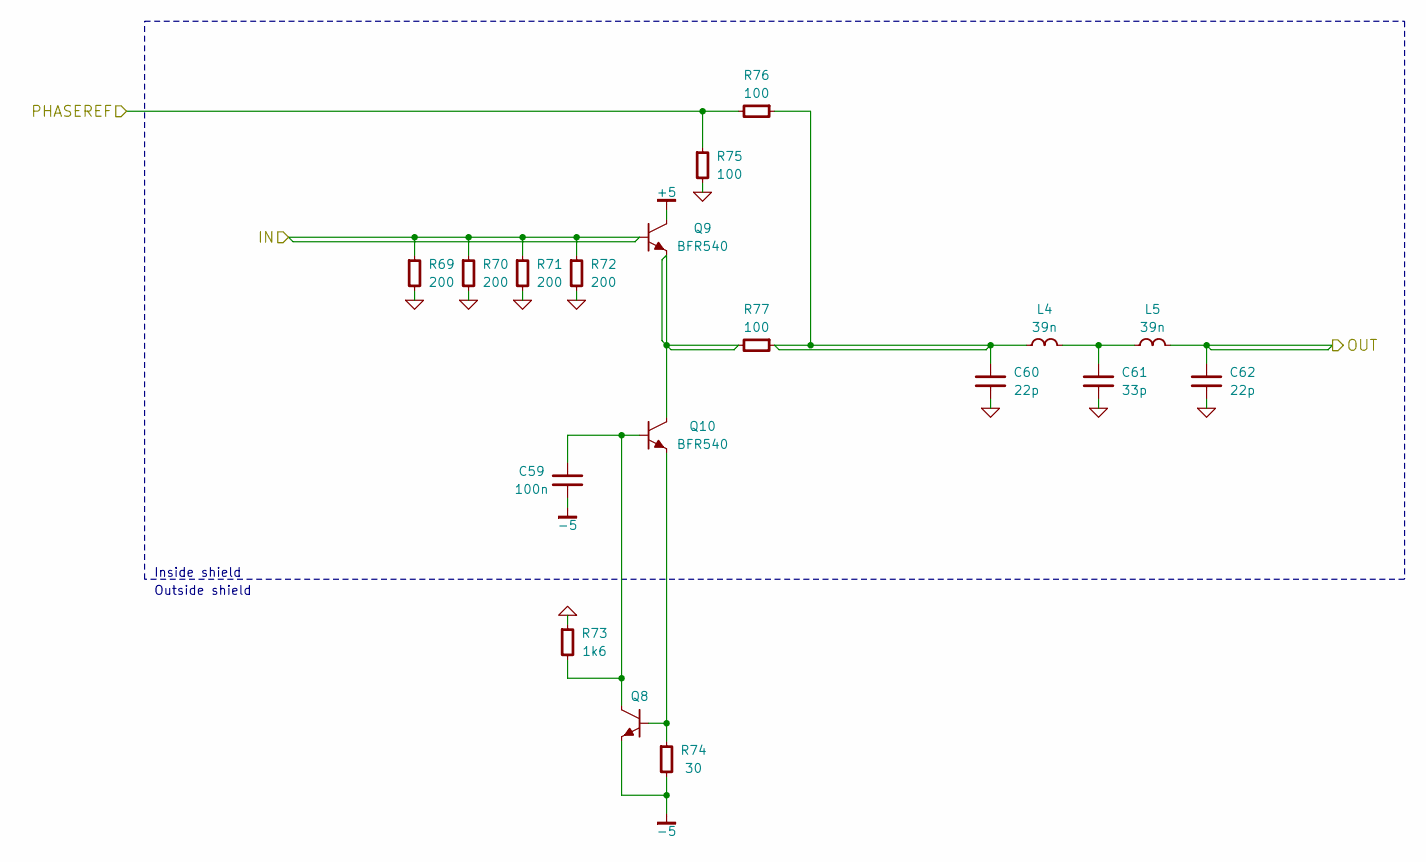
[picture p34: schematic Buffer_Filter.sch, Input Buffer and Filter]

Parts:
C59: 100n; CAPC1608X55
C60, C62: 22p; CAPC1608X55
C61: 33p; CAPC1608X55
L4, L5: 39n; INDC1005X60
Q8: MMBT3904; SOT-23
Q9, Q10: BFR540; SOT-23
R69, R70, R71, R72: 200; RESC1608X50
R73: 1k6; RESC1608X50
R74: 30; RESC1608X50
R75, R76, R77: 100; RESC1608X50

Connections:
+5: Q9.3; also elsewhere on the board
-5: C59.2, Q8.2, R74.2; also elsewhere on the board
/InputFrontend/Buffer_Filter/IN: Q9.1, R69.1, R70.1, R71.1, R72.1; also elsewhere on the board
/InputFrontend/Detector/IN: C62.1, L5.1; also elsewhere on the board
/Synth/OUT1: R75.1, R76.2; also elsewhere on the board
GND: C60.2, C61.2, C62.2, R69.2, R70.2, R71.2, R72.2, R73.1, R75.2; also elsewhere on the board
unnamed: C59.1, Q8.3, Q10.1, R73.2
unnamed: C60.1, L4.2, R76.1, R77.1
unnamed: C61.1, L4.1, L5.2
unnamed: Q8.1, Q10.2, R74.1
unnamed: Q9.2, Q10.3, R77.2

Notes on the sheet:
Inside shield
Outside shield

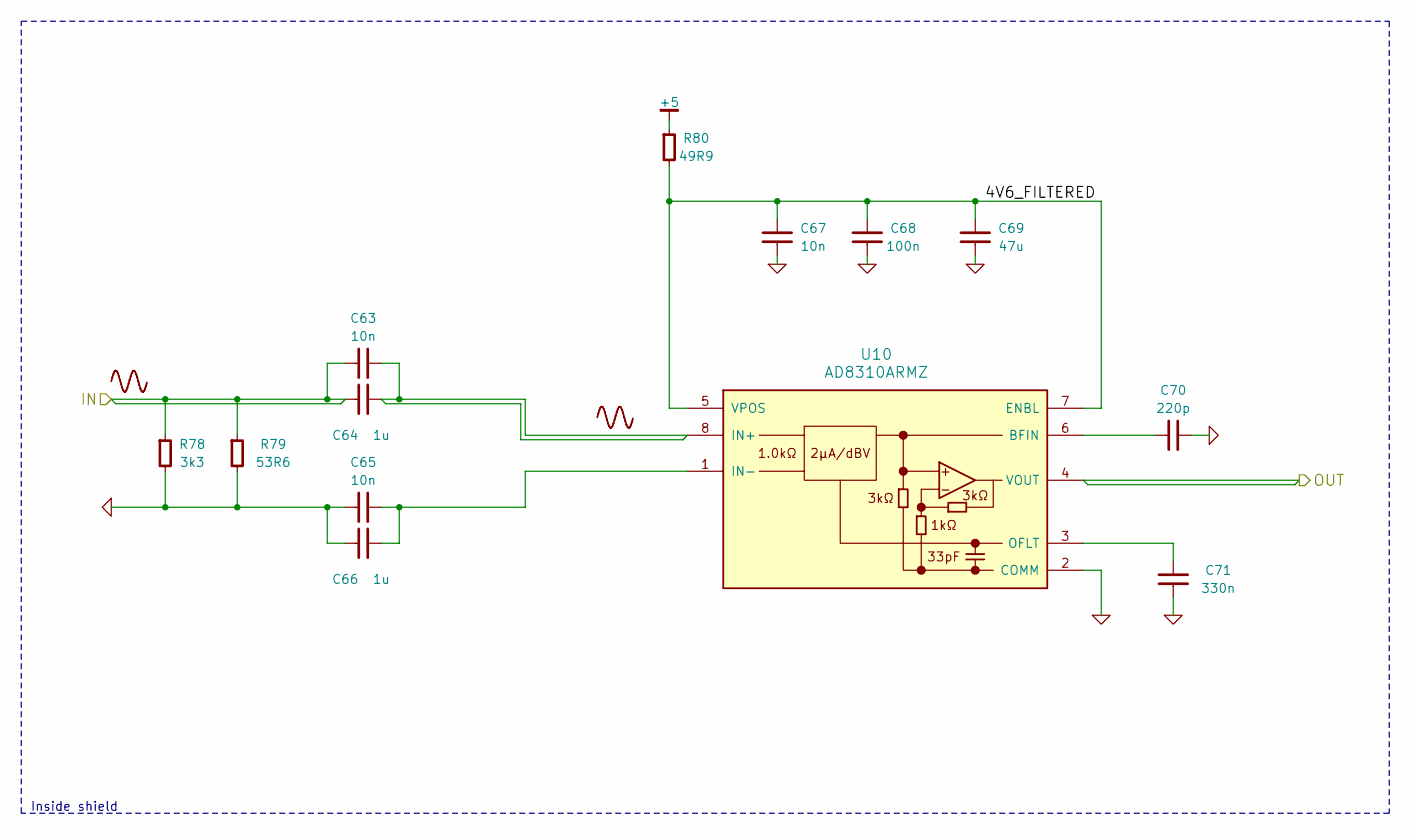
[picture p35: schematic Detector.sch, Logarithmic Detector]

Parts:
C63, C65, C67: 10n; CAPC1608X55
C64, C66: 1u; CAPC2012X70
C68: 100n; CAPC1608X55
C69: 47u; CAPC3216X70
C70: 220p; CAPC1608X55
C71: 330n; CAPC1608X55
R78: 3k3; RESC1608X50
R79: 53R6; RESC1608X50
R80: 49R9; RESC1608X50
U10: AD8310ARMZ; SOP65P490X109-8

Connections:
+5: R80.1; also elsewhere on the board
/InputFrontend/Detector/4V6_FILTERED: C67.1, C68.1, C69.1, R80.2, U10.5 (VPOS), U10.7 (ENBL)
/InputFrontend/Detector/IN: C63.2, C64.2, R78.1, R79.1; also elsewhere on the board
/InputFrontend/Detector/OUT: U10.4 (VOUT); also elsewhere on the board
GND: C65.2, C66.2, C67.2, C68.2, C69.2, C70.1, C71.2, R78.2, R79.2, U10.2 (COMM); also elsewhere on the board
unnamed: C63.1, C64.1, U10.8 (IN+)
unnamed: C65.1, C66.1, U10.1 (IN-)
unnamed: C70.2, U10.6 (BFIN)
unnamed: C71.1, U10.3 (OFLT)

Notes on the sheet:
Inside shield

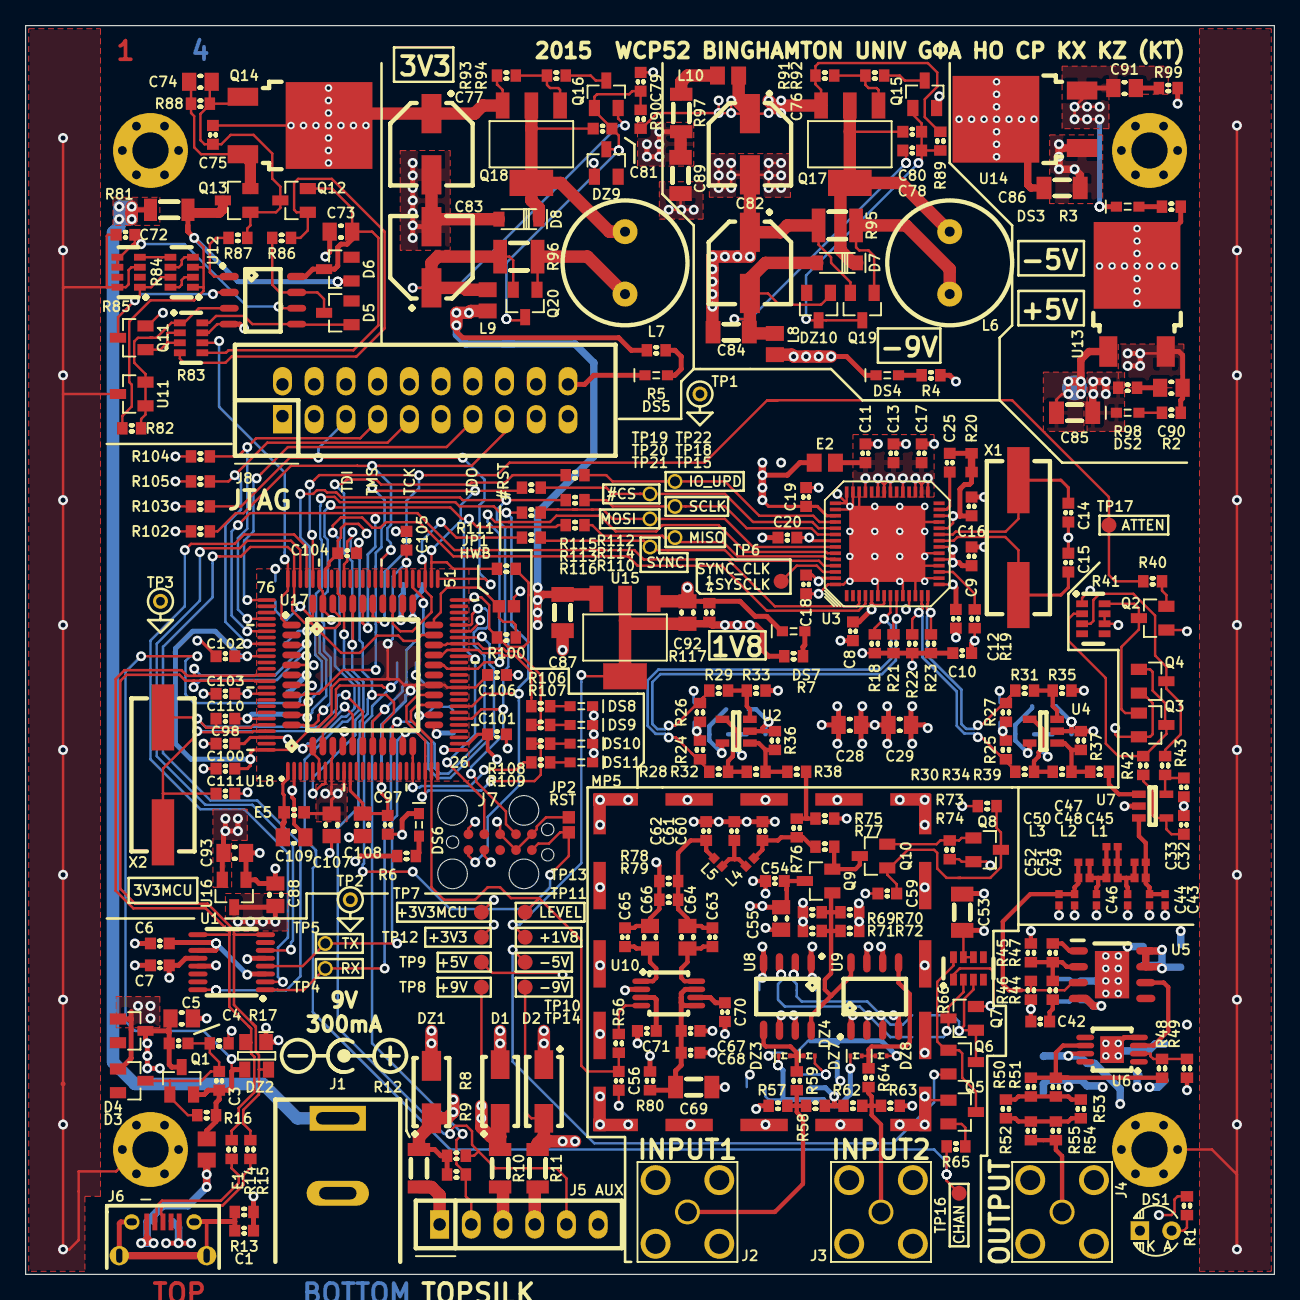
[picture p36: board wcp52.kicad_pcb from above]

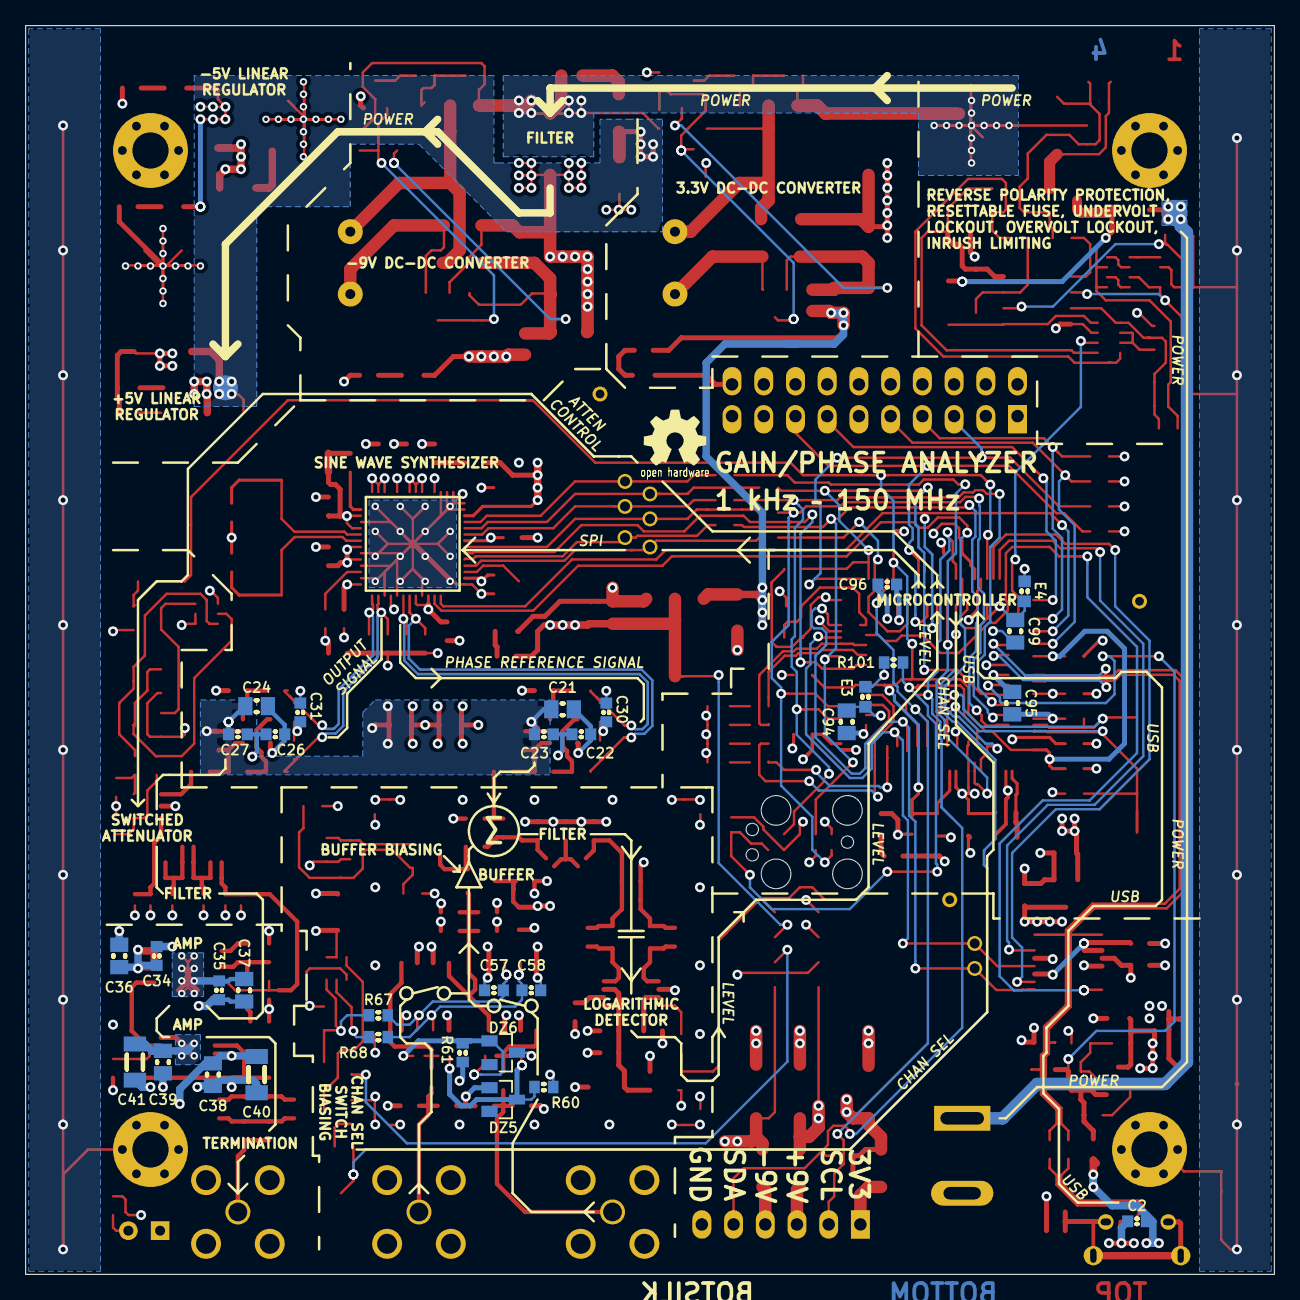
[picture p37: board wcp52.kicad_pcb from below]

Board: 4 copper layers, 100.0 x 100.0 mm, 349 parts (32 on the bottom side), 170 nets.
