WCP52/gpha/Firmware/wcp52fw/src/main.c

/**
 * \file
 * Main loop and initializers.
 */

// libc includes
#include <assert.h>
#include <ctype.h>
#include <inttypes.h>
#include <stdio.h>
#include <string.h>

// Atmel ASF includes
#include <pio.h>
#include <spi.h>
#include <spi_master.h>
#include <stdio_usb.h>
#include <sysclk.h>
#include "conf_board.h"
#include "usb-functions.h"

// Software libraries
#include "scpi/scpi.h"
#include "scpi-def.h"
#include "util.h"

// Hardware support
#include "acquisition.h"
#include "synth.h"

static void pins_init(void);

/**
 * Initialize the board
 */
// Cannot declare static, as board.h declares this extern
void board_init(void)
{
    // Disable watchdog timer
    WDT->WDT_MR = WDT_MR_WDDIS;

	sysclk_enable_peripheral_clock(ID_PIOA);
	sysclk_enable_peripheral_clock(ID_PIOB);
	sysclk_enable_peripheral_clock(ID_PIOC);

    pins_init();
    pmc_enable_periph_clk(ID_PIOB);
}

/**
 * Initialize the SPI controller.
 */
static void spi_init(void)
{
    /* Configure an SPI peripheral. */
    spi_enable_clock(SPI_MASTER_BASE);
    spi_disable(SPI_MASTER_BASE);
    spi_reset(SPI_MASTER_BASE);
    spi_set_lastxfer(SPI_MASTER_BASE);
    spi_set_master_mode(SPI_MASTER_BASE);
    spi_disable_mode_fault_detect(SPI_MASTER_BASE);
    spi_set_peripheral_chip_select_value(SPI_MASTER_BASE, SPI_CHIP_PCS);
    spi_set_clock_polarity(SPI_MASTER_BASE, SPI_CHIP_SEL, SPI_CLK_POLARITY);
    spi_set_clock_phase(SPI_MASTER_BASE, SPI_CHIP_SEL, SPI_CLK_PHASE);
    spi_set_bits_per_transfer(SPI_MASTER_BASE, SPI_CHIP_SEL,
            SPI_CSR_BITS_8_BIT);
    spi_set_baudrate_div(SPI_MASTER_BASE, SPI_CHIP_SEL,
            (sysclk_get_cpu_hz() / 100000uL));
    spi_set_transfer_delay(SPI_MASTER_BASE, SPI_CHIP_SEL, SPI_DLYBS,
            SPI_DLYBCT);
    spi_enable(SPI_MASTER_BASE);
}

/**
 * Configure all device pins
 */
static void pins_init(void)
{
    size_t i;
    for (i = 0; PIN_TABLE[i].description; ++i) {
        if (!PIN_TABLE[i].index_str) continue; // Pin group, not pin
        pio_configure_pin(PIN_TABLE[i].index, PIN_TABLE[i].flags);
    }
}

/**
 * Main function.
 *
 * \return Unused (ANSI-C compatibility).
 */
int main(void)
{
    // Initialize all used peripherals.
    sysclk_init();
    irq_initialize_vectors();
    cpu_irq_enable();
    board_init();
    spi_init();
    adc_setup();
    stdio_usb_init();
    pio_set_pin_high(GPIO_LED1);
    
    SCPI_Init(&G_SCPI_CONTEXT);

    const size_t SMBUFFER_SIZE = 10;
    char smbuffer[10];
    for (;;) {
        // Get into smbuffer until either full, or a \r or \n
        size_t i;
        i = 0;
        while (i < SMBUFFER_SIZE - 1) {
            char ch = 0;
            if (G_CDC_ENABLED) {
                ch = udi_cdc_getc();
            } else {
                continue;
            }
            if (!ch) {
                continue;
            }
            if (ch == '\r' || ch == '\n') {
                smbuffer[i] = ch;
                ++i;
                break;
            } else {
                smbuffer[i] = ch;
                ++i;
            }
        }
        smbuffer[i] = 0; // Terminate!
        SCPI_Input(&G_SCPI_CONTEXT, smbuffer, strlen (smbuffer));
    }

    return 0;
}
