WCP52/gpha/(commit log)

2015-03-15 Marked power splitter as optional
2015-03-18 Add BOM/schematic
2015-03-18 More BOM work
2015-03-18 Schematic fixed
2015-03-21 Updated BOM
2015-04-01 Propagated updates from schematic
2015-04-11 Add initial files
    LED blink works, USART does not.
2015-04-11 Fix screwed-up repo
2015-04-11 Use floating-point printf
2015-04-11 Implement TEST:LEDON, TEST:LEDOFF
2015-04-11 Write SCPI reset function
    [main.c]
2015-04-11 Add SYNCIO pin to Test:SET
2015-04-11 Add amplitude and phase control code
    added monkeybutts of SPI ampltude and phase
2015-04-11 Add Test:SAMple (no ADC code yet)
2015-04-11 Revert "Temporary commit"
    This reverts commit 2f33baf6dfdd27b3e39f1499db614684b5c031f0.
    [main.c]
2015-04-11 Add USB driver
2015-04-11 Set VID/PID (might be temporary)
2015-04-11 Migrate code to new PCB
2015-04-11 Add new programmer config
    [flash.cfg]
2015-04-11 Compiles and runs on final PCB
2015-04-11 Change VID/PID, clean up conf_usb.h
2015-04-11 Add lowlevel pin control
    LOWlevel:SETpin
    LOWlevel:CLRpin
    LOWlevel:GETpin
    LOWlevel:LISTpins
2015-04-11 Move files into Firmware
    [flash.cfg]
2015-04-11 Add block diagram
    [Comm.sch, InputFrontend.sch, MPU.sch, OutputAmp.sch, PowerSupply.sch, Synth.sch, wcp52.sch]
2015-04-11 Add synth schematic
    [Comm.sch, InputFrontend.sch, MPU.sch, OutputAmp.sch, PowerSupply.sch, Synth.sch, wcp52.sch]
2015-04-11 Add output amplifier schematic
    [Comm.sch, InputFrontend.sch, LPF.sch, MPU.sch, OutputAmp.sch, PowerSupply.sch, Synth.sch, wcp52.sch]
2015-04-11 Add frontend
    [Buffer_Filter.sch, Comm.sch, Detector.sch, InputFrontend.sch, LPF.sch, MPU.sch, OutputAmp.sch, PowerSupply.sch]
2015-04-11 Add power input circuit
    [Buffer_Filter.sch, Comm.sch, Detector.sch, InputFrontend.sch, LPF.sch, MPU.sch, OutputAmp.sch, PowerInput.sch]
2015-04-11 Add DC-DC
    [Buffer_Filter.sch, Comm.sch, DCDC.sch, DCDCneg9.sch, Detector.sch, InputFrontend.sch, LPF.sch, MPU.sch]
2015-04-11 Complete power supply design
    [DCDC.sch]
2015-04-11 Finish USB subcircuit
    [Buffer_Filter.sch, Comm.sch, DCDC.sch, Detector.sch, InputFrontend.sch, LPF.sch, MPU.sch, OutputAmp.sch]
2015-04-11 Begin adding MCU
    [MPU.sch]
2015-04-11 Start PCB
    [Buffer_Filter.sch, Comm.sch, DCDC.sch, Detector.sch, InputFrontend.sch, LPF.sch, MPU.sch, OutputAmp.sch]
2015-04-11 Begin swapping MCU
    [MPU.sch, wcp52.kicad_pcb]
2015-04-11 PCB work, mostly mechanical
    [Buffer_Filter.sch, Comm.sch, DCDC.sch, Detector.sch, InputFrontend.sch, LPF.sch, MPU.sch, OutputAmp.sch]
2015-04-11 Layout most analog bits
    [Buffer_Filter.sch, DCDC.sch, Detector.sch, InputFrontend.sch, LPF.sch, OutputAmp.sch, PowerInput.sch, Protection.sch]
2015-04-11 Add side bars, ground plane
    [wcp52.kicad_pcb]
2015-04-11 Lots of routing
    [DCDC.sch, wcp52.kicad_pcb]
2015-04-11 Lots of layout work
    [Buffer_Filter.sch, Comm.sch, DCDC.sch, Detector.sch, InputFrontend.sch, LPF.sch, MPU.sch, OutputAmp.sch]
2015-04-11 Some PCB work
    [wcp52.kicad_pcb]
2015-04-11 All parts placed
    [Buffer_Filter.sch, Comm.sch, DCDC.sch, Detector.sch, InputFrontend.sch, LPF.sch, MPU.sch, OutputAmp.sch]
2015-04-11 Some power layout
    [wcp52.kicad_pcb]
2015-04-11 Power plane layout
    [wcp52.kicad_pcb]
2015-04-11 Major layout work - almost done
    [Buffer_Filter.sch, DCDC.sch, Detector.sch, InputFrontend.sch, PowerInput.sch, Protection.sch, Switching.sch, wcp52.kicad_pcb]
2015-04-11 Place final traces
    [wcp52.kicad_pcb]
2015-04-11 Add I2C to header
    [Buffer_Filter.sch, Comm.sch, DCDC.sch, Detector.sch, InputFrontend.sch, LPF.sch, MPU.sch, OutputAmp.sch]
2015-04-11 Clean up silkscreen
    [wcp52.kicad_pcb]
2015-04-11 Add overload protection to aux power output
    [Buffer_Filter.sch, Comm.sch, DCDC.sch, Detector.sch, InputFrontend.sch, LPF.sch, MPU.sch, OutputAmp.sch]
2015-04-11 Add some test points
    [DCDC.sch, MPU.sch, Synth.sch, wcp52.kicad_pcb]
2015-04-11 Tidy up F.Cu
    [MPU.sch, wcp52.kicad_pcb]
2015-04-11 Tidy up In1.Cu
    [wcp52.kicad_pcb]
2015-04-11 Add more 3D models
    [wcp52.kicad_pcb]
2015-04-11 Connect attenuator control
    [MPU.sch, wcp52.kicad_pcb, wcp52.sch]
2015-04-11 Add power LED
    [Buffer_Filter.sch, Comm.sch, DCDC.sch, Detector.sch, InputFrontend.sch, LPF.sch, MPU.sch, OutputAmp.sch]
2015-04-11 Some work removing unnecessary bits
    [Buffer_Filter.sch, Comm.sch, DCDC.sch, Detector.sch, InputFrontend.sch, LPF.sch, MPU.sch, OutputAmp.sch]
2015-04-11 Clean up resistor BOM
    [Buffer_Filter.sch, Comm.sch, DCDC.sch, Detector.sch, InputFrontend.sch, LPF.sch, MPU.sch, OutputAmp.sch]
2015-04-11 Tweak layout
    [DCDC.sch, MPU.sch, wcp52.kicad_pcb, wcp52.sch]
2015-04-11 Swap 0402 to 0603, add USB inrush protection
    [Buffer_Filter.sch, Comm.sch, DCDC.sch, Detector.sch, InputFrontend.sch, LPF.sch, MPU.sch, OutputAmp.sch]
2015-04-11 Touch up PCB
    [Protection.sch, wcp52.kicad_pcb, wcp52.sch]
2015-04-11 Add test LEDs
    [MPU.sch, Synth.sch, wcp52.kicad_pcb]
2015-04-11 Set unnecessary FT230 parts "DNP"
    [Comm.sch]
2015-04-11 Add postprocessing
    [wcp52.kicad_pcb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]
2015-04-11 Swap inner layers
    [wcp52.kicad_pcb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]
2015-04-11 Add legends to Gerbers
    [wcp52.kicad_pcb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]
2015-04-11 Add SPI series resistors
    [DCDC.sch, MPU.sch, Synth.sch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]
2015-04-11 Fix page sizes
    [Buffer_Filter.sch, Comm.sch]
2015-04-11 Fix paste mask
    [wcp52.kicad_pcb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]
2015-04-11 Quick adjustment of silkscreen designator
    [wcp52.kicad_pcb]
2015-04-11 Add alternative MCU
    [MPU.sch, wcp52.kicad_pcb]
2015-04-11 Connect ICSP for new MCU
    [Comm.sch, MPU.sch, wcp52.kicad_pcb, wcp52.sch]
2015-04-11 Reorganize files
    [Buffer_Filter.sch, Comm.sch, DCDC.sch, DCDCneg9.sch, Detector.sch, InputFrontend.sch, LPF.sch, MPU.sch]
2015-04-11 Render converter only runs when necessary
    [wcp52.kicad_pcb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]
2015-04-11 Minor routing fixes
    [wcp52.kicad_pcb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]
2015-04-11 Route DDS's SDIO1 to MCUs
    Just in case...
    [MPU.sch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]
2015-04-11 Add #CS pullup resistor
    [MPU.sch, wcp52.kicad_pcb]
2015-04-11 Route UART to alt MCU
    [MPU.sch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]
2015-04-11 Set min. mask width properly
    [wcp52.kicad_pcb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]
2015-04-11 Reorganize MPU schematic
    [MPU.sch, Synth.sch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]
2015-04-11 Add reset jumper
    [MPU.sch, wcp52.kicad_pcb]
2015-04-11 Connect #SLEEP to AVR
    [MPU.sch, wcp52.kicad_pcb]
2015-04-11 Fix NPTH issue
    [wcp52.kicad_pcb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]
2015-04-11 Minor silk/routing/thermal pad fixes
    [wcp52.kicad_pcb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]
2015-04-11 Paste mask fixes
    [wcp52.kicad_pcb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]
2015-04-11 Route LEDs to AVR
    [MPU.sch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]
2015-04-11 Remove extra connections
    [MPU.sch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]
2015-04-11 Add PSU filter inductors
    [Comm.sch, DCDC.sch, InputFrontend.sch, LPF.sch, OutputAmp.sch, PowerInput.sch, Synth.sch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]
2015-04-11 Test point fixes
    [Comm.sch, wcp52.kicad_pcb]
2015-04-11 Add back drawing
    [wcp52.kicad_pcb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]
2015-04-11 Add panel power LED
    [Buffer_Filter.sch, Comm.sch, DCDC.sch, Detector.sch, InputFrontend.sch, LPF.sch, MPU.sch, OutputAmp.sch]
2015-04-11 Add power rail diag LEDs
    [Buffer_Filter.sch, Comm.sch, DCDC.sch, Detector.sch, InputFrontend.sch, LPF.sch, MPU.sch, OutputAmp.sch]
2015-04-11 Move ATTEN test point to near attenuator
    [wcp52.kicad_pcb]
2015-04-11 Quick tweaks, renders
    [wcp52.kicad_pcb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]
2015-04-11 Reannotate parts. May need to tweak silkscreen
    [Buffer_Filter.sch, Comm.sch, DCDC.sch, DCDCneg9.sch, Detector.sch, InputFrontend.sch, LPF.sch, MPU.sch]
2015-04-11 Silkscreen tweaks, renders
    [wcp52.kicad_pcb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]
2015-04-11 Correct spacing of USB differential pair
    [wcp52.kicad_pcb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]
2015-04-11 Schematic touchups
    [Buffer_Filter.sch, Comm.sch, DCDC.sch, Detector.sch, InputFrontend.sch, LPF.sch, MPU.sch, OutputAmp.sch]
2015-04-11 Minor silkscreen fix
    [wcp52.kicad_pcb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]
2015-04-11 Change schematic pages to letter size
    [Buffer_Filter.sch, Comm.sch, DCDC.sch, Detector.sch, InputFrontend.sch, LPF.sch, MPU.sch, OutputAmp.sch]
2015-04-11 Correct BOM lines
    The BOM reader currently cannot interpret things like '3k3'.
    [DCDC.sch, Detector.sch, InputFrontend.sch]
2015-04-11 BOM fixes
    [Buffer_Filter.sch, Comm.sch, DCDC.sch, Detector.sch, InputFrontend.sch, LPF.sch, MPU.sch, OutputAmp.sch]
2015-04-11 Prepare to fab
    [Buffer_Filter.sch, Comm.sch, DCDC.sch, Detector.sch, InputFrontend.sch, LPF.sch, MPU.sch, OutputAmp.sch]
2015-04-11 BOM line fixes
    [Buffer_Filter.sch, Comm.sch, DCDC.sch, DCDCneg9.sch, Detector.sch, InputFrontend.sch, LPF.sch, MPU.sch]
2015-04-11 BOM corrections/combinations, etc
    Add configuration for bomtool
    Remove old schematic file no longer used
    [Buffer_Filter.sch, Comm.sch, DCDC.sch, DCDCneg9.sch, InputFrontend.sch, LPF.sch, MPU.sch, OutputAmp.sch]
2015-04-11 Widen tolerance on a capacitor
    [Detector.sch]
2015-04-11 More BOM stuff
2015-04-11 BOM stuff
2015-04-11 Schematic/doc work
    [Buffer_Filter.sch, Comm.sch, DCDC.sch, Detector.sch, InputFrontend.sch, LPF.sch, MPU.sch, OutputAmp.sch]
2015-04-11 Schematic updates for documentation
    [Buffer_Filter.sch, Comm.sch, DCDC.sch, Detector.sch, InputFrontend.sch, LPF.sch, MPU.sch, OutputAmp.sch]
2015-04-11 More doc fixes
    [wcp52.sch]
2015-04-11 Nicer BOM lines
    [Buffer_Filter.sch, Comm.sch, DCDC.sch, Detector.sch, InputFrontend.sch, LPF.sch, MPU.sch, OutputAmp.sch]
2015-04-11 Add post-testing revision, todo notes
    [Buffer_Filter.sch, Comm.sch, DCDC.sch, Detector.sch, InputFrontend.sch, LPF.sch, MPU.sch, OutputAmp.sch]
2015-04-11 Fix BOM
    D5 was removed, so should not be in the BOM
    [LPF.sch, PowerInput.sch]
2015-04-11 Move files into PCB/
    [Buffer_Filter.sch, Comm.sch, DCDC.sch, Detector.sch, InputFrontend.sch, LPF.sch, MPU.sch, OutputAmp.sch]
2015-04-16 Program with J-Link
    [jlink.cfg]
2015-04-19 Update documentation
    Correct LaTeX Makefile: don't include README.rst
    Add local .gitignore
    Add microcontroller documentation
    Update schematic renders
    [Buffer_Filter.sch, Comm.sch, DCDC.sch, Detector.sch, InputFrontend.sch, LPF.sch, MPU.sch, OutputAmp.sch]
2015-05-07 Add status LED
